LuZening/OPA2000/product1.jpg

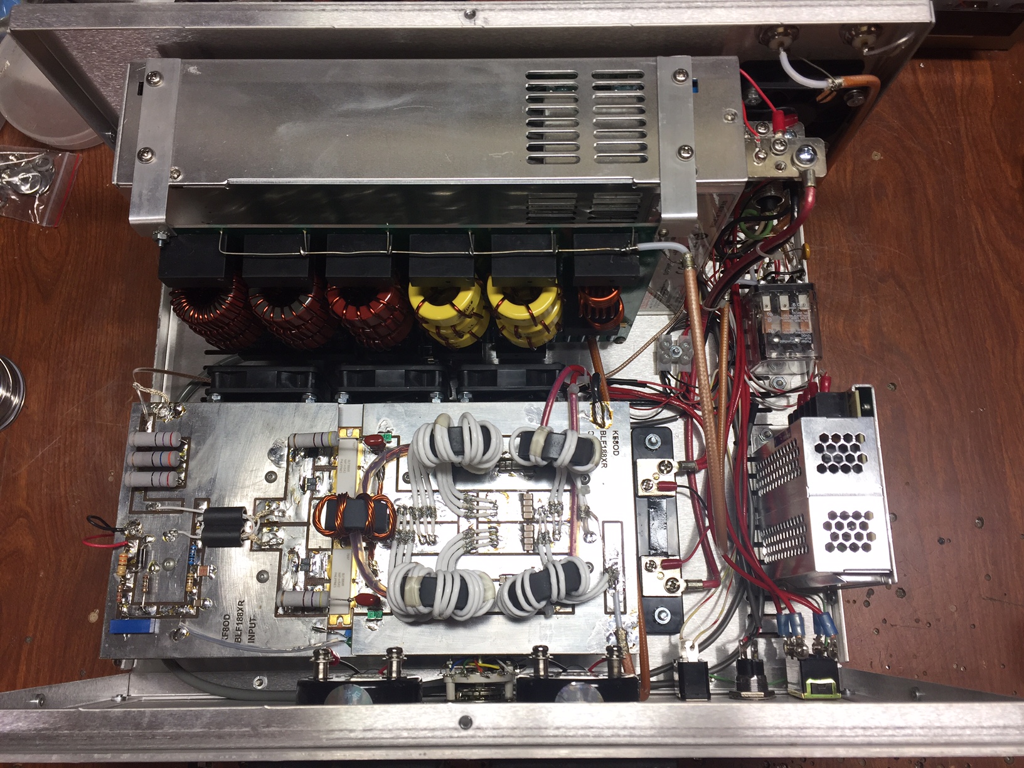
product1.jpg
