LuZening/OPA2000/BOM_HighSidePower_PCB1_2026-02-28.xlsx

No. | Quantity | Comment | Designator | Footprint | Value | Manufacturer Part | Manufacturer | Supplier Part | Supplier
1 | 1 | 3V3 | 3V3 | Test-Point-0.5mm
2 | 1 | 12V | 12V | Test-Point-0.5mm
3 | 8 | 100nF | C1,C4,C8,C18,C19,C21,C22,C25 | C0805 | 100nF | CC0805KRX7R9BB104 | YAGEO(国巨) | C49678 | LCSC
4 | 3 | 1nF | C2,C3,C5 | C0805 | 1nF | CC0805KRX7R9BB102 | YAGEO(国巨) | C94121 | LCSC
5 | 4 | 1uF | C6,C7,C15,C20 | C0805 | 1uF | CC0805KKX7R9BB105 | YAGEO(国巨) | C91185 | LCSC
6 | 1 | 2.2nF | C9 | C0805 | 2.2nF | CC0805KRX7R9BB222 | YAGEO(国巨) | C107146 | LCSC
7 | 2 | 22uF | C10,C12 | CAP-SMD_BD6.3-L6.6-W6.6-FD-A | 22uF | 2201010609TR | NJCON(永立) | C19270543 | LCSC
8 | 1 | 10nF | C11 | C1206 | 10nF | 1206B103K251NT | FH(风华) | C913956 | LCSC
9 | 2 | 100nF 100V | C13,C17 | C0805 | 100nF 100V | CL21B104KCFNNNE | SAMSUNG(三星) |  | LCSC
10 | 2 | 4.7uF | C14,C16 | C1210 | 4.7uF | FS32X475K101EGG | PSA(信昌电陶) | C381466 | LCSC
11 | 2 | 22uF | C23,C24 | C1206 | 22uF | CL31A226KAHNNNE | SAMSUNG(三星) | C12891 | LCSC
12 | 6 | M2螺丝 | CONN1,CONN2,CONN3,CONN4,CONN5,CONN6 | PCB-10B-M4
13 | 1 | 5.0SMDJ60CA | D1 | SMC_L6.9-W5.9-LS7.9-BI |  | 5.0SMDJ60CA | R+O(宏嘉诚) | C42371726 | LCSC
14 | 2 | B5819W SL | D2,D3 | SOD-123_L2.7-W1.6-LS3.7-RD-1 |  | B5819W SL | CJ(江苏长电/长晶) | C8598 | LCSC
15 | 2 | FR107 | D5,D6 | SOD-123_L2.8-W1.8-LS3.7-RD |  | FR107 | JSMSEMI(杰盛微) | C963379 | LCSC
16 | 1 | SS310 | D7 | SMA_L4.3-W2.6-LS5.0-FD |  | SS310 | R+O(宏嘉诚) | C7420364 | LCSC
17 | 1 | ZMM5V1 | D8 | LL-34_L3.5-W1.5-RD |  | ZMM5V1 | HXY MOSFET(华轩阳电子) | C5345992 | LCSC
18 | 1 | SMD4532-075NF | GDT1 | DIO-DT-SMD_L4.5-W3.2 |  | SMD4532-075NF | RUILON(瑞隆源) | C9234 | LCSC
19 | 1 | 0 | GNDSPLIT1 | GNDSPLIT0603 | 0
20 | 1 | GOSC | GOSC | Test-Point-0.5mm
21 | 2 | ZX-XH2.54-4PWT | J1,J2 | CONN-SMD_4P-P2.50-WAFER-254W-4P |  | ZX-XH2.54-4PWT | Megastar(兆星) | C7429673 | LCSC
22 | 4 | ZX-XH2.54-2PWT | J3,J4,J5,J6 | CONN-SMD_2P-P2.54_MEGASTAR_ZX-XH2.54-2PWT |  | ZX-XH2.54-2PWT | Megastar(兆星) | C7429671 | LCSC
23 | 1 | 33uH | L1 | IND-SMD_L13.45-W12.6 | 33uH | MWSA1206S-330MT | Sunlord(顺络) | C408530 | LCSC
24 | 1 | LED_0805-G | LED1 | LED_0805
25 | 1 | OSCH | OSCH | Test-Point-0.5mm
26 | 1 | OSCL | OSCL | Test-Point-0.5mm
27 | 1 | SP010N01BGHTO | Q1 | TOLL-8_L10.4-W9.9-P1.20-LS11.7-BL_2 |  | SP010N01BGHTO | Siliup(矽普) | C22385350 | LCSC
28 | 1 | 2N7002 | Q2 | SOT-23-3_L2.9-W1.3-P1.90-LS2.4-BR |  | 2N7002 | R+O(宏嘉诚) | C7420321 | LCSC
29 | 1 | 2N5401 | Q3 | SOT-23-3_L2.9-W1.3-P0.95-LS2.4-BR |  | 2N5401 | LJ(朗捷) | C18195370 | LCSC
30 | 1 | CMD25P15 | Q4 | TO-252-2_L6.5-W6.1-P4.56-LS9.9-BR-CW-1 |  | CMD25P15 | Cmos(广东场效应半导体) | C18198747 | LCSC
31 | 8 | 100 | R1,R2,R3,R4,R5,R11,R29,R30 | R0805 | 100
32 | 2 | 10k | R6,R34 | R0805 | 10k
33 | 1 | 300k 1% | R7 | R0805 | 300k 1%
34 | 2 | 10k 1% | R8,R14 | R0805 | 10k 1%
35 | 3 | 100k | R9,R22,R31 | R0805 | 100k
36 | 1 | 39k | R10 | R0805 | 39k
37 | 1 | 51k | R12 | R0805 | 51k
38 | 2 | 1k | R13,R28 | R0805 | 1k
39 | 1 | 3.3k 1% | R15 | R0805 | 3.3k 1%
40 | 1 | 500k | R16 | R1206 | 500k
41 | 1 | 50 | R17 | R0805 | 50
42 | 3 | 5.1k | R18,R25,R26 | R0805 | 5.1k
43 | 1 | 220mΩ | R19 | R1206 | 220mΩ | 1206W4F220LT5E | UNI-ROYAL(厚声) | C25336 | LCSC
44 | 1 | 5.6k 1% | R20 | R0805 | 5.6k 1%
45 | 1 | 4.7k 1% | R21 | R0805 | 4.7k 1%
46 | 1 | 1.8M | R23 | R0805 | 1.8M
47 | 2 | 68k | R24,R27 | R0805 | 68k
48 | 1 | 9.09k | R32 | R0805 | 9.09k
49 | 2 | M3螺丝 | SCREW1,SCREW2 | M3_BD6.2
50 | 1 | ZX-XH2.54-2PLT | SW1 | CONN-SMD_2P-P2.50_HCTL_HC-XH-2ALT |  | ZX-XH2.54-2PLT | Megastar(兆星) | C7429680 | LCSC
51 | 1 | CC6920BSO-50A | U1 | SOP-8_L5.0-W4.0-P1.27-LS6.0-BL |  | CC6920BSO-50A | CrossChip(成都芯进) | C2880436 | LCSC
52 | 2 | ZMM15V | U2,U4 | LL-34_L3.5-W1.5-RD |  | ZMM15V | HXY MOSFET(华轩阳电子) | C5346000 | LCSC
53 | 1 | NSG2000 | U3 | SOIC-8_L4.9-W3.9-P1.27-LS6.1-BL |  | NSG2000 | WXNSIC(国硅集成) | C41414507 | LCSC
54 | 1 | TPSPX3819M5-L-3-3 | U5 | SOT-23-5_L3.0-W1.6-P0.95-LS2.8-BR |  | TPSPX3819M5-L-3-3 | TECH PUBLIC(台舟) | C5370980 | LCSC
55 | 1 | SI5351A-B-GTR | U6 | MSOP-10_L3.0-W3.0-P0.50-LS5.0-BL |  | SI5351A-B-GTR | SKYWORKS/SILICON LABS(芯科) | C504891 | LCSC
56 | 1 | LMR38020FSQDDARQ1 | U7 | ESOP-8_L4.9-W3.9-P1.27-LS6.0-BL-EP |  | LMR38020FSQDDARQ1 | TI(德州仪器) | C20345530 | LCSC
57 | 2 | LMV358Q3MAX/NOPB | U8,U9 | SOIC-8_L5.0-W4.0-P1.27-LS6.1-BL |  | LMV358Q3MAX/NOPB | TI(德州仪器) | C2867121 | LCSC
58 | 1 | ACS758LCB-050B-PFF-T | U10 | SENSOR-TH_ACS758LCB-050B-PFF-T |  | ACS758LCB-050B-PFF-T | ALLEGRO(美国埃戈罗) | C73426 | LCSC
59 | 1 | SN74LVC1G126DBVR | U11 | SOT-23-5_L3.0-W1.7-P0.95-LS2.8-BR |  | SN74LVC1G126DBVR | TI(德州仪器) | C7834 | LCSC
60 | 1 | VG | VG | Test-Point-0.5mm
61 | 1 | VG2 | VG2 | Test-Point-0.5mm
62 | 1 | Vpump | Vpump | Test-Point-0.5mm
63 | 1 | 25MHz | X1 | CRYSTAL-SMD_4P-L3.2-W2.5-BL | 25MHz | X322525MOB4SI | YXC(扬兴晶振) | C9006 | LCSC
