LuZening/OPA2000/MCU_2/BOM_Control_Control_2026-10-15.xlsx

No. | Quantity | Comment | Designator | Footprint | Value | Manufacturer | Supplier
1 | 1 | 4kHz | BZ1 | BUZ-SMD_L5.0-W5.5-P4.60 | 4kHz | 华能 | LCSC
2 | 31 | 100nF | C1,C2,C3,C4,C5,C6,C7,C9,C11,C13,C14,C15,C18,C21,C46,C49,C51,C55,C62,C63,C64,C65,C66,C83,C85,C87,C88,C100,C101,C102,C104 | C0402 | 100nF | SAMSUNG(三星) | LCSC
3 | 2 | 12pF | C8,C12 | C0402 | 12pF | FH(风华) | LCSC
4 | 2 | 2.2uF | C10,C16 | C0603 | 2.2uF
5 | 1 | 2.2uF | C17 | C0603 | 2.2uF | YAGEO(国巨) | LCSC
6 | 2 | 2.2uF | C19,C20 | C0603 | 2.2uF | SAMSUNG(三星) | LCSC
7 | 11 | 10uF | C22,C23,C43,C95,C96,C97,C98,C99,C107,C109,C117 | C0603 | 10uF
8 | 5 | 100nF | C24,C76,C77,C79,C80 | C0402 | 100nF
9 | 18 | 1uF | C25,C26,C27,C28,C29,C34,C39,C40,C47,C52,C56,C57,C58,C59,C89,C90,C91,C92 | C0603 | 1uF
10 | 4 | 22uF | C30,C31,C37,C38 | C1206 | 22uF | Chinocera(华瓷) | LCSC
11 | 3 | 100nF | C32,C33,C36 | C0603 | 100nF
12 | 3 | 18pF | C35,C81,C82 | C0402 | 18pF
13 | 9 | 10nF | C41,C60,C61,C68,C69,C72,C73,C74,C78 | C0402 | 10nF
14 | 12 | 1nF | C42,C44,C53,C54,C108,C110,C111,C112,C113,C114,C115,C116 | C0402 | 1nF | YAGEO(国巨) | LCSC
15 | 5 | 10uF | C45,C48,C50,C93,C94 | CAP-SMD_BD4.0-L4.3-W4.3-LS5.0-FD | 10uF | KNSCHA(科尼盛) | LCSC
16 | 2 | 2.2nF | C67,C70 | C0603 | 2.2nF
17 | 2 | 220pF | C71,C75 | C0603 | 220pF
18 | 2 | 33p | C84,C86 | C0603 | 33p
19 | 1 | 1uF | C103 | C0402 | 1uF | SAMSUNG(三星) | LCSC
20 | 2 | 1uF | C105,C106 | C0603 | 1uF | SAMSUNG(三星) | LCSC
21 | 1 | FAN1 | CN1 | CONN-TH_KF2510-4P |  |  | LCSC
22 | 1 | FAN2/PUMP | CN2 | CONN-TH_KF2510-4P |  |  | LCSC
23 | 1 | PJ-320D | CN3 | AUDIO-SMD_PJ-320D-1 |  | SHOU HAN(首韩) | LCSC
24 | 1 | REAR | CN4 | FPC-SMD_KH-FG0.5-H2.0-20PIN |  | kinghelm(金航标) | LCSC
25 | 1 | SMAJ15CA | D1 | SMA_L4.3-W2.6-LS5.0-BI |  | R+O(宏嘉诚) | LCSC
26 | 16 | BZT52C3V3S | D2,D3,D6,D7,D8,D9,D10,D11,D12,D13,D14,D15,D17,D18,D25,D26 | SOD-323_L1.7-W1.3-LS2.6-RD |  | R+O(宏嘉诚) | LCSC
27 | 7 | 1N5819WS | D4,D16,D19,D20,D21,D22,D23 | SOD-323_L1.8-W1.3-LS2.5-RD |  | Hottech(合科泰) | LCSC
28 | 1 | 1N4148WS | D5 | SOD-323_L1.8-W1.3-LS2.5-RD |  | CJ(江苏长电/长晶) | LCSC
29 | 1 | TPESD0502S6 | D24 | SOT-23-6_L2.9-W1.6-P0.95-LS2.8-BR |  | TECH PUBLIC(台舟) | LCSC
30 | 1 | BSMD1206-200-16V | F1 | F1206 |  | BHFUSE(佰宏) | LCSC
31 | 1 | CTouch | FPC1 | FPC-SMD_6P-P0.50_HC-FPC-05-09-6RLTAG |  | HCTL(华灿天禄) | LCSC
32 | 1 | FPC-05FB-40PH20 | FPC2 | FPC-SMD_40P-P0.50_XUNPU_FPC-05FB-40PH20 |  | XUNPU(讯普) | LCSC
33 | 1 | EXT_DISP | FPC3 | FPC-SMD_8P-P0.50_HC-FPC-05-09-8RLTAG |  | HCTL(华灿天禄) | LCSC
34 | 1 | PROG | H1 | HDR-SMD_8P-P2.54-V-M-R2-C4-LS7.4 |  | LAILAN(莱联) | LCSC
35 | 1 | CAN | H2 | CONN-SMD_B2B-PH-SM4-TB-LF-SN |  | JST | LCSC
36 | 1 | PSU ON | H3 | CONN-SMD_B2B-PH-SM4-TB-LF-SN |  | JST | LCSC
37 | 1 | PTT IN | H4 | CONN-SMD_B2B-PH-SM4-TB-LF-SN |  | JST | LCSC
38 | 1 | RELAY1 | H5 | CONN-SMD_B2B-PH-SM4-TB-LF-SN |  | JST | LCSC
39 | 1 | RELAY2 | H6 | CONN-SMD_B2B-PH-SM4-TB-LF-SN |  | JST | LCSC
40 | 1 | RF_IN | H7 | CONN-SMD_6P-P2.00_XUNPU_WAFER-PH2.0-6PWB |  | XUNPU(讯普) | LCSC
41 | 1 | NTC | H8 | CONN-SMD_B2B-PH-SM4-TB-LF-SN |  | JST | LCSC
42 | 1 | LIGHT | H9 | CONN-SMD_4P-P2.00_WAFER-200L-4A |  | XUNPU(讯普) | LCSC
43 | 1 | POWER | H10 | CONN-SMD_4P-P2.00_XUNPU_WAFER-PH2.0-4PWB |  | XUNPU(讯普) | LCSC
44 | 1 | POWER EXT | H11 | CONN-SMD_4P-P2.00_MEGASTAR_ZX-PH2.0-LT4P |  | Megastar(兆星) | LCSC
45 | 1 | LPF_SW | H12 | CONN-SMD_8P-P2.00_XUNPU_WAFER-PH2.0-8PWB |  | XUNPU(讯普) | LCSC
46 | 1 | COUPLER1 | H13 | CONN-SMD_6P-P2.00_XUNPU_WAFER-PH2.0-6PWB |  | XUNPU(讯普) | LCSC
47 | 1 | COUPLER2 | H14 | CONN-SMD_6P-P2.00_XUNPU_WAFER-PH2.0-6PWB |  | XUNPU(讯普) | LCSC
48 | 1 | 3.3uH | L1 | IND-SMD_L4.0-W4.0 | 3.3uH | cjiang(长江微电) | LCSC
49 | 2 | BLM18PG121SN1D | L2,L3 | L0603 |  | muRata(村田) | LCSC
50 | 1 | 22uH | L4 | IND-SMD_L4.0-W4.0_FNR40XXS | 22uH | cjiang(长江微电) | LCSC
51 | 1 | KT-0805G | LED1 | LED0805-R-RD |  | KENTO | LCSC
52 | 1 | KT-0805R | LED2 | LED0805-R-RD |  | KENTO | LCSC
53 | 3 | S8050 | Q1,Q8,Q9 | SOT-23-3_L2.9-W1.3-P1.90-LS2.4-BR |  | JSMSEMI(杰盛微) | LCSC
54 | 1 | AO3402 | Q2 | SOT-23_L2.9-W1.3-P1.90-LS2.4-BR |  | AOS | LCSC
55 | 3 | SS8050 | Q3,Q4,Q5 | SOT-23-3_L2.9-W1.3-P1.90-LS2.4-BR |  | R+O(宏嘉诚) | LCSC
56 | 2 | S9018 | Q6,Q7 | SOT-23-3_L2.9-W1.3-P1.90-LS2.4-BR |  | R+O(宏嘉诚) | LCSC
57 | 1 | SS8550 | Q10 | SOT-23-3_L2.9-W1.3-P1.90-LS2.4-BR |  | R+O(宏嘉诚) | LCSC
58 | 4 | 22k | R1,R5,R6,R11 | R0402 | 22k | UNI-ROYAL(厚声) | LCSC
59 | 9 | 2.2k | R2,R4,R7,R8,R23,R28,R37,R84,R94 | R0402 | 2.2k
60 | 21 | 22k | R3,R13,R15,R24,R25,R40,R41,R59,R60,R64,R65,R69,R71,R72,R73,R88,R109,R110,R111,R112,R113 | R0402 | 22k
61 | 3 | 2.2k | R9,R10,R75 | R0402 | 2.2k | UNI-ROYAL(厚声) | LCSC
62 | 1 | 22 | R12 | R0603 | 22 | UNI-ROYAL(厚声) | LCSC
63 | 2 | 100k | R14,R18 | R0603 | 100k
64 | 2 | 60 | R16,R17 | R0603 | 60
65 | 3 | 56k | R19,R21,R22 | R0402 | 56k
66 | 1 | 10K | R20 | R0603 | 10K
67 | 5 | 220k | R26,R27,R38,R70,R74 | R0402 | 220k
68 | 14 | 22 | R29,R30,R78,R79,R80,R81,R82,R83,R85,R86,R87,R98,R117,R118 | R0402 | 22
69 | 7 | 22 | R36,R43,R45,R47,R49,R76,R77 | R0603 | 22
70 | 1 | 22k | R39 | R0603 | 22k
71 | 9 | 12k | R42,R50,R51,R56,R57,R63,R66,R67,R68 | R0603 | 12k
72 | 4 | 8.2k | R44,R46,R48,R52 | R0603 | 8.2k
73 | 6 | 220 | R53,R54,R55,R58,R61,R62 | R0603 | 220
74 | 1 | 1M | R114 | R0603 | 1M
75 | 2 | 5.1k | R115,R116 | R0402 | 5.1k
76 | 2 | 6GHz | RF1,RF2 | IPEX-SMD_3P-L2.6-W2.6-LS3.0_RF1200001R | 6GHz | HanElectricity(瀚源) | LCSC
77 | 14 | 22Ω | RN1,RN2,RN3,RN4,RN5,RN6,RN7,RN8,RN9,RN10,RN11,RN12,RN13,RN14 | RES-ARRAY-SMD_0603-8P-L3.2-W1.6-BL | 22Ω | UNI-ROYAL(厚声) | LCSC
78 | 1 | HDR-M_2.54_1x1P | S1 | 屏蔽罩26x26夹6.5x1.28
79 | 3 | M2螺丝 | SCREW1,SCREW2,SCREW3 | M2螺丝
80 | 1 | M2螺丝 | SCREW4 | M2-D2.8-BD4.4
81 | 1 | TF-01A | SD1 | TF-SMD_TF-01A |  | 韩国韩荣 | LCSC
82 | 1 | TS1101B16025 | SW1 | KEY-SMD_L6.1-W3.7-LS8.0 |  | HanElectricity(瀚源) | LCSC
83 | 1 | Test-Point | TP2 | Test-Point-0.5mm
84 | 1 | FREQ_DET_A | TP3 | Test-Point-0.5mm
85 | 1 | FREQ_DET_Y | TP4 | Test-Point-0.5mm
86 | 1 | STM32H7B0ZBT | U1 | LQFP-144_L20.0-W20.0-P0.50-LS22.0-TL |  | ST(意法半导体)
87 | 1 | GS8552-SR | U2 | MSOP-8_L3.0-W3.0-P0.65-LS4.9-TL |  | Gainsil(聚洵) | LCSC
88 | 1 | W25Q64JVSSIQ | U3 | SOIC-8_L5.3-W5.3-P1.27-LS8.0-BL |  | Winbond(华邦) | LCSC
89 | 1 | 12V | U4 | CONN-SMD_ZX-XH2.54-2PLT |  | Megastar(兆星) | LCSC
90 | 1 | TJA1042T/1J | U5 | SOIC-8_L5.0-W4.0-P1.27-LS6.0-BL |  | NXP(恩智浦) | LCSC
91 | 1 | ME6211C33M5G-N | U6 | SOT-23-5_L3.0-W1.7-P0.95-LS2.8-BL |  | MICRONE(南京微盟) | LCSC
92 | 2 | 662K | U7,U9 | SOT-23-3_L2.9-W1.3-P1.90-LS2.4-BR |  | HXY MOSFET(华轩阳电子) | LCSC
93 | 1 | TMI3255TF | U8 | SOT-23-6_L2.9-W1.6-P0.95-LS2.9-BL |  | TMI(拓尔微) | LCSC
94 | 1 | TPS2116DRLR | U10 | SOT-583-8_L2.1-W1.6-P0.50-LS1.6-BL |  | TI(德州仪器) | LCSC
95 | 1 | 74LVC1G14GV | U11 | SOT-23-5_L3.0-W1.7-P0.95-LS2.8-BR |  | TECH PUBLIC(台舟) | LCSC
96 | 1 | SI5351A-B-GTR | U12 | MSOP-10_L3.0-W3.0-P0.50-LS5.0-BL |  | SKYWORKS/SILICON LABS(芯科) | LCSC
97 | 2 | TLV9061M5/TR | U13,U14 | SOT-23-5_L3.0-W1.5-P0.95-LS2.8-BL |  | HGSEMI(华冠) | LCSC
98 | 1 | ES8388 | U15 | QFN-28_L4.0-W4.0-P0.45-BL-EP |  | Everest-semi(顺芯) | LCSC
99 | 1 | NS2009 | U16 | MSOP-10_L3.0-W3.0-P0.50-LS5.0-BL |  | Nsiway(纳芯威) | LCSC
100 | 1 | AP3019AKTR-G1 | U19 | SOT-23-6_L2.9-W1.6-P0.95-LS2.8-BR |  | DIODES(美台) | LCSC
101 | 1 | KEYS | U20 | CONN-SMD_4P-P2.00_C2001RS10411M0101RC |  | Megastar(兆星) | LCSC
102 | 1 | TYPE-C 16PIN 2MD(073) | USB1 | USB-C-SMD_TYPE-C-16PIN-2MD-073 |  | SHOU HAN(首韩) | LCSC
103 | 1 | 12.288MHz | X1 | CRYSTAL-SMD_4P-L3.2-W2.5-BL | 12.288MHz | YXC(扬兴晶振) | LCSC
