LuZening/OPA2000/Power_2/HighSideDriving/power_BOM.csv

Comment | Description | Designator | Footprint | LibRef | Pins | Quantity | PartNumber | url
1nF | desc | C1,C20,C24, | 0805_C | libref | 2 | 3
1uF | desc | C2,C12,C25, | 0805_C | libref | 2 | 3
104 63V | desc | C3, | 1206_C | libref | 2 | 1
63V 4.7uF | desc | C4, | 1210_C | libref | 2 | 1
104 | desc | C5, | 0805_C | libref | 2 | 1
104 | desc | C6,C9,C10,C15,C18,C19,C21,C22, | 0805_C | libref | 2 | 8
6.8pF NP0 | desc | C7, | 0805_C | libref | 2 | 1
3.3nF NP0 | desc | C8, | 0805_C | libref | 2 | 1
100uF 16V | desc | C11, | CP_Elec_6.3x5.8 | libref | 2 | 1
103 | desc | C13,C26, | 0805_C | libref | 2 | 2
16V | desc | D1, | LL-34 | libref | 2 | 1
SK310 | desc | D2, | SMC(DO-214AB)_S1 | libref | 2 | 1
D_TVS | desc | D4, | SMC(DO-214AB)_S1 | libref | 2 | 1
IFault | desc | D8, | 0805_LED | libref | 2 | 1
VFault | desc | D9, | 0805_LED | libref | 2 | 1
4148 | desc | D10,D11, | SOD-123 | libref | 2 | 2
Power | desc | D12, | 0805_LED | libref | 2 | 1
Conn_01x02 | desc | J2, | JST_PH_B2B-PH-SM4-TB_02x2.00mm_Straight | libref | 4 | 1
Conn_01x03 | desc | J4, | JST_PH_B3B-PH-SM4-TB_03x2.00mm_Straight | libref | 5 | 1
Conn_01x04 | desc | J5, | JST_PH_B4B-PH-SM4-TB_04x2.00mm_Straight | libref | 6 | 1
120uH 3A | desc | L1, | L_12.6mm_13.5mm | libref | 2 | 1
2N5551 | desc | Q1,Q5, | SOT-23(SOT-23-3) | libref | 3 | 2
SUP90P06 | desc | Q2, | TO-220-External_Thermal_Mount | libref | 3 | 1
8050 | desc | Q6, | SOT-23(SOT-23-3) | libref | 3 | 1
2N5401 | desc | Q7,Q8, | SOT-23(SOT-23-3) | libref | 3 | 2
MJD127 | desc | Q9, | TO-252-2 | libref | 3 | 1
47K 1% | desc | R1,R26, | 0805_R | libref | 2 | 2
2.2K 1% | desc | R2, | 0805_R | libref | 2 | 1
10K | desc | R3,R4,R6,R32,R33,R40,R41,R45, | 0805_R | libref | 2 | 8
100K | desc | R5,R14, | 0805_R | libref | 2 | 2
33K | desc | R7, | 0805_R | libref | 2 | 1
1K | desc | R8,R9,R29,R30,R31, | 0805_R | libref | 2 | 5
2M | desc | R10, | 0805_R | libref | 2 | 1
51K | desc | R11, | 0805_R | libref | 2 | 1
70K 1% | desc | R12, | 0805_R | libref | 2 | 1
47K | desc | R13,R17,R18,R21,R23,R25, | 0805_R | libref | 2 | 6
330K | desc | R15, | 0805_R | libref | 2 | 1
470K | desc | R16, | 0805_R | libref | 2 | 1
68K | desc | R19, | 0805_R | libref | 2 | 1
8.2K | desc | R20, | 0805_R | libref | 2 | 1
2K | desc | R22, | 0805_R | libref | 2 | 1
1R 1/2W | desc | R24, | R_1812_4532Metric | libref | 2 | 1
3.3K | desc | R34,R35, | 0805_R | libref | 2 | 2
10K 1% | desc | R36,R38,R39, | 0805_R | libref | 2 | 3
6.8K 1% | desc | R37, | 0805_R | libref | 2 | 1
680 | desc | R42, | 0805_R | libref | 2 | 1
22K 1% | desc | R43,R44, | 0805_R | libref | 2 | 2
LMV358 | desc | U1,U2, | SOIC-8_150MIL | libref | 8 | 2
TPS54260 | desc | U3, | MSOP-10-1EP_W3mm | libref | 11 | 1
TL431 | desc | U6, | SOT-23(SOT-23-3) | libref | 3 | 1
Zener | desc | TP1, | TestPoint_Pad_1.0x1.0mm | libref | 1 | 1
OVX | desc | TP2, | TestPoint_Pad_1.0x1.0mm | libref | 1 | 1
BuckVin | desc | TP3, | TestPoint_Pad_1.0x1.0mm | libref | 1 | 1
ImSense | desc | TP4, | TestPoint_Pad_1.0x1.0mm | libref | 1 | 1
VmSense | desc | TP5, | TestPoint_Pad_1.0x1.0mm | libref | 1 | 1
12V | desc | TP7, | TestPoint_Pad_1.0x1.0mm | libref | 1 | 1
5V | desc | TP8, | TestPoint_Pad_1.0x1.0mm | libref | 1 | 1
Through Hole Items
1uF 100V | desc | C14, | CP_Radial_D5.0mm_P2.50mm | libref | 2 | 1
GND | desc | J1,J6,J7, | PCB-10B-M4 | libref | 2 | 3
50V in | desc | J3, | PCB-10B-M4 | libref | 2 | 1
Conn_01x04 | desc | J8, | PhoenixContact_MC-G_04x3.81mm_Angled | libref | 4 | 1
ACS758xCB-100U-PFF | desc | U4, | Allegro_CB_PFF | libref | 37 | 1
47K | desc | RV1, | Potentiometer_Bourns_3296W_Vertical | libref | 3 | 1
GND | desc | SC1,SC2, | M3_Screwhole | libref | 7 | 2
