LuZening/OPA2000/RF_2/OPA2000_RF/RF_input/BOM_RF_Input_RF_Input_2026-09-01.xlsx

No. | Quantity | Comment | Designator | Footprint | Value | Manufacturer Part | Manufacturer | Supplier Part | Supplier
1 | 1 | 10uF | C1 | CAP-SMD_BD4.0-L4.3-W4.3-LS5.0-FD | 10uF | RST10UF25V014 | KNSCHA(科尼盛) | C4747969 | LCSC
2 | 5 | 100nF | C2,C5,C16,C20,C24 | C0603 | 100nF
3 | 4 | 100nF | C3,C4,C6,C7 | C0805 | 100nF
4 | 3 | 1uF | C8,C9,C17 | C0603 | 1uF
5 | 2 | 10nF | C10,C11 | C0603 | 10nF
6 | 4 | 1nF | C12,C13,C14,C15 | C0805 | 1nF | CC0805KRX7R9BB104 | YAGEO(国巨) |  | LCSC
7 | 1 | 200pF | C18 | C0603 | 200pF
8 | 1 | 22uF | C19 | C0603 | 22uF
9 | 1 | 1nF | C21 | C0603 | 1nF
10 | 2 | 10uF | C22,C23 | C0603 | 10uF
11 | 1 | BX-PH2.0-6PLT | CONN1 | CONN-SMD_6P-P2.00_BX-PH2.0-6PLT |  | BX-PH2.0-6PLT | Bossie(博锡) | C18077903 | LCSC
12 | 1 | WAFER-PH2.0-2PLB | CONN2 | CONN-TH_2P-P2.00_XUNPU_WAFER-PH2.0-2PLB |  | WAFER-PH2.0-2PLB | XUNPU(讯普) | C3029431 | LCSC
13 | 1 | D_PIN | D1 | DIO-SMD_L3.0-W2.2_MA4P1250-1072T-A1K2 | D_PIN
14 | 5 | 1N5819WS | D2,D3,D28,D29,D30 | SOD-323_L1.8-W1.3-LS2.5-RD |  | 1N5819WS | Hottech(合科泰) | C191023 | LCSC
15 | 1 | ZMM3V3 | D4 | LL-34_L3.5-W1.5-RD |  | ZMM3V3 | Slkor(萨科微) | C707189 | LCSC
16 | 20 | DSS34 | D5,D6,D7,D8,D9,D10,D11,D12,D13,D14,D17,D18,D19,D20,D21,D22,D23,D24,D25,D26 | SOD-123_L2.8-W1.8-LS3.7-RD-2 |  | DSS34 | CJ(江苏长电/长晶) | C2923958 | LCSC
17 | 2 | BAT54S | D15,D16 | SOT-23-3_L2.9-W1.3-P1.90-LS2.4-BR |  | BAT54S | R+O(宏嘉诚) | C7420333 | LCSC
18 | 7 | Test-Point | IM,IMREF,OPATT,OPREF,OVERP,VBIAS,VPIN | Test-Point-0.5mm
19 | 1 | RFin | J1 | RF_conn_pad_2 | SMA
20 | 1 | 10T | L1 | 28B0562-100-RFC | 10T
21 | 2 | KT-0805R | LED1,LED2 | LED0805-R-RD |  | KT-0805R | KENTO | C2295 | LCSC
22 | 1 | 2N5551 | Q1 | SOT-23-3_L2.9-W1.3-P1.90-LS2.4-BL-1 |  | 2N5551 | GOODWORK(固得沃克) | C51912414 | LCSC
23 | 1 | BCP56(RANGE:100-250) | Q2 | SOT-223-3_L6.5-W3.4-P2.30-LS7.0-BR |  | BCP56(RANGE:100-250) | CJ(江苏长电/长晶) | C95810 | LCSC
24 | 1 | BLF188XR | Q3 | BLF188XR-Gate | BLF188XR
25 | 1 | NPN_BIAS_TEMPSENSE | Q4 | TO-92-SMD
26 | 1 | SS8550 Y2(RANGE:200-350) | Q5 | SOT-23-3_L2.9-W1.3-P1.90-LS2.4-BR |  | SS8550 Y2(RANGE:200-350) | CJ(江苏长电/长晶) | C8542 | LCSC
27 | 1 | SS8550 | Q6 | SOT-23-3_L2.9-W1.3-P1.90-LS2.4-BR |  | SS8550 | R+O(宏嘉诚) | C7420371 | LCSC
28 | 1 | SS8050 | Q7 | SOT-23-3_L2.9-W1.3-P1.90-LS2.4-BR |  | SS8050 | R+O(宏嘉诚) | C7420370 | LCSC
29 | 2 | 10 | R1,R7 | R2512 | 10 | CR1812J240RE04Z | EVER OHMS(天二科技) |  | LCSC
30 | 2 | 240Ω | R2,R2* | R2512 | 240Ω | CR1812J240RE04Z | EVER OHMS(天二科技) | C149837 | LCSC
31 | 9 | 22k | R3,R6,R10,R11,R33,R37,R38,R40,R41 | R0603 | 22k
32 | 2 | 220k | R4,R27 | R0603 | 220k
33 | 2 | 10k | R5,R13 | R0603 | 10k
34 | 2 | 1k | R8,R39 | R0603 | 1k
35 | 2 | 220 | R9,R25 | R0603 | 220
36 | 9 | 2.2k | R12,R28,R29,R30,R31,R32,R34,R42,R43 | R0603 | 2.2k
37 | 4 | 22 | R14,R15,R35,R46 | R0603 | 22
38 | 1 | 33 | R16 | R2512 | 33 | CR1812J240RE04Z | EVER OHMS(天二科技) |  | LCSC
39 | 8 | 47 | R17,R18,R19,R20,R21,R22,R23,R24 | R0805 | 47
40 | 1 | 2kΩ | R26 | RES-ADJ-SMD_3224W | 2kΩ | 3224W-1-202E | BOURNS | C116322 | LCSC
41 | 3 | 10kΩ | R44,R45,R47 | RES-ADJ-SMD_3314J | 10kΩ | 3314J-1-103E | BOURNS | C36376 | LCSC
42 | 1 | HFD4/5-SR | RELAY1 | RELAY-SMD_HFD4-5-SR |  | HFD4/5-SR | HF(宏发) | C64399 | LCSC
43 | 3 | M3螺丝 | SCREW1,SCREW2,SCREW3 | M3_BD6.2
44 | 1 | Transformer_4_1 | T1 | 28B0562-100-1_4_UNUN | Transformer_4_1
45 | 1 | GS8552-SR | U1 | MSOP-8_L3.0-W3.0-P0.65-LS4.9-TL |  | GS8552-SR | Gainsil(聚洵) | C157716 | LCSC
46 | 1 | LM393 | U2 | MSOP-8_L3.0-W3.0-P0.65-LS4.9-TL |  | LM393 | IDCHIP(英锐芯) | C400839 | LCSC
47 | 2 | GS8721 | U4,U6 | SOT-23-5_L3.0-W1.7-P0.95-LS2.8-BL |  | GS8721 | RUNIC(润石) | C236995 | LCSC
48 | 1 | TL431D | U5 | SOT-23-3_L3.0-W1.7-P0.95-LS2.9-BR |  | TL431D | R+O(宏嘉诚) | C55111440 | LCSC
