LuZening/OPA2000/Interface_2/BOM_Interface_Interface_2026-10-13.xlsx

No. | Quantity | Comment | Designator | Footprint | Value | Manufacturer | Supplier
1 | 13 | 100nF | C1,C2,C3,C4,C6,C12,C13,C18,C24,C25,C28,C30,C31 | C0603 | 100nF
2 | 3 | 1nF | C5,C8,C15 | C0603 | 1nF
3 | 1 | 100pF | C7 | C0603 | 100pF
4 | 3 | 10nF | C9,C22,C26 | C0603 | 10nF
5 | 4 | 1uF | C10,C11,C14,C23 | C0603 | 1uF
6 | 1 | 2.2nF | C16 | C0603 | 2.2nF
7 | 1 | 100uF | C17 | CAP-SMD_BD6.3-L6.6-W6.6-LS7.4-FD | 100uF | ChengTao(诚韬) | LCSC
8 | 4 | 10uF | C19,C20,C21,C29 | C0603 | 10uF
9 | 1 | 270p | C27 | C0603 | 270p
10 | 1 | HYC33-VGA18A-158 | CN1 | DSUB-TH_HYC33-VGA18A-158 |  | HOAUC(华宇创) | LCSC
11 | 5 | PJ-320D | CN2,CN3,CN4,CN5,CN6 | AUDIO-SMD_PJ-320D-1 |  | SHOU HAN(首韩) | LCSC
12 | 1 | REAR | CN7 | FPC-SMD_KH-FG0.5-H2.0-20PIN |  | kinghelm(金航标) | LCSC
13 | 2 | ZX-XH2.54-2PWT | CN8,CN9 | CONN-SMD_2P-P2.54_MEGASTAR_ZX-XH2.54-2PWT |  | Megastar(兆星) | LCSC
14 | 8 | SMF15CA | D1,D2,D3,D4,D5,D6,D9,D12 | SOD-123FL_L2.7-W1.8-LS3.8-BI |  | R+O(宏嘉诚) | LCSC
15 | 4 | SMF5.0CA | D7,D8,D18,D19 | SOD-123FL_L2.7-W1.8-LS3.8-BI |  | R+O(宏嘉诚) | LCSC
16 | 1 | 1N4007W | D10 | SOD-123FL_L2.7-W1.8-LS3.8-RD |  | R+O(宏嘉诚) | LCSC
17 | 7 | 1N5819WS | D11,D15,D17,D20,D21,D22,D23 | SOD-323_L1.8-W1.3-LS2.5-RD |  | Hottech(合科泰) | LCSC
18 | 2 | PESD5V0S1BA,115 | D13,D14 | SOD-323_L1.7-W1.3-LS2.5-BI |  | Nexperia(安世) | LCSC
19 | 1 | PESD1CAN | D16 | SOT-23-3_L2.9-W1.6-P1.90-LS2.8-BR |  | BORN(伯恩半导体) | LCSC
20 | 1 | PROG | H1 | HDR-SMD_8P-P2.54-V-M-R2-C4-LS7.4 |  | LAILAN(莱联) | LCSC
21 | 2 | HX PZ2.54-2x4P ZZ | HEADER1,HEADER2 | HDR-TH_8P-P2.54-V-M-R2-C4-S2.54 |  | hanxia(韩下) | LCSC
22 | 1 | WAFER-MX1.25-4PWB | J1 | CONN-SMD_4P-P1.25_WAFER-MX1.25-4PWB |  | XUNPU(讯普) | LCSC
23 | 1 | 2.2uH | L1 | IND-SMD_L2.5-W2.0_WPN252012H | 2.2uH | Sunlord(顺络) | LCSC
24 | 1 | bead | L2 | L0805 |  | muRata(村田) | LCSC
25 | 1 | KT-0603W | LED1 | LED0603-R-RD_WHITE |  | KENTO | LCSC
26 | 1 | MMBT5551(RANGE:200-300) | Q3 | SOT-23-3_L2.9-W1.3-P1.90-LS2.4-BR |  | CJ(江苏长电/长晶) | LCSC
27 | 1 | MMBT5401(RANGE:200-300) | Q4 | SOT-23-3_L2.9-W1.3-P1.90-LS2.4-BR |  | CJ(江苏长电/长晶) | LCSC
28 | 2 | DTC143ZE | Q5,Q6 | SOT-523-3_L1.6-W0.8-P1.00-LS1.6-BR |  | CJ(江苏长电/长晶) | LCSC
29 | 11 | 22 | R1,R2,R3,R4,R5,R23,R24,R25,R39,R40,R41 | R0603 | 22
30 | 12 | 22k | R6,R9,R10,R14,R16,R30,R37,R38,R42,R43,R45,R46 | R0603 | 22k
31 | 2 | 2.2 | R7,R21 | R0603 | 2.2
32 | 1 | 51k | R8 | R0603 | 51k
33 | 6 | 2.2k | R11,R15,R26,R28,R47,R48 | R0603 | 2.2k
34 | 2 | 220 | R12,R18 | R0603 | 220
35 | 1 | 1k | R13 | R0603 | 1k
36 | 1 | 33k | R17 | R0603 | 33k
37 | 5 | 5.1k | R19,R20,R50,R51,R52 | R0603 | 5.1k
38 | 1 | 100k | R22 | R0603 | 100k
39 | 1 | 100 | R27 | R0603 | 100
40 | 1 | 12k | R29 | R0603 | 12k
41 | 4 | 49.9 | R31,R32,R33,R34 | R0603 | 49.9
42 | 2 | 330 | R35,R36 | R0603 | 330
43 | 1 | 10k | R44 | R0603 | 10k
44 | 1 | HR913550AE | RJ1 | RJ45-TH_HR913550AE |  | HANRUN(汉仁) | LCSC
45 | 1 | M3螺丝 | SCREW1 | M3_Screwhole
46 | 2 | M2螺丝 | SCREW2,SCREW3 | M2-D2.8-BD4.4
47 | 2 | HC-PM254-5.0H-2x4PZ-02A | SOCK1,SOCK2 | CONN-TH_HC-PM254-5.0H-2X4PZ-02A |  | HC(虹成电子) | LCSC
48 | 1 | TK-6580A-1 | SW1 | SW-TH_TK-6580A-1 |  | Yuandi(元迪) | LCSC
49 | 5 | Test-Point | TP1,TP2,TP3,TP4,TP5 | Test-Point-0.5mm
50 | 1 | LM358 | U1 | SOP-8_L4.9-W3.9-P1.27-LS6.0-BL |  | MSKSEMI(美森科) | LCSC
51 | 1 | SP3232EEY-L/TR | U2 | TSSOP-16_L5.0-W4.4-P0.65-LS6.4-BL |  | MaxLinear(迈凌) | LCSC
52 | 1 | PC817C-S | U3 | SOP-4_L6.5-W4.6-P2.54-LS10.3-TL |  | UMW(友台半导体) | LCSC
53 | 1 | TPS60403DBVR | U4 | SOT-23-5_L3.0-W1.7-P0.95-LS2.8-BR |  | TI(德州仪器) | LCSC
54 | 1 | SY8088A | U5 | SOT-23-5_L2.9-W1.6-P0.95-LS2.8-BL |  | TECH PUBLIC(台舟) | LCSC
55 | 1 | LAN8720 | U6 | QFN24
56 | 1 | 2.4GHz | U7 | WIFI-SMD_ESP32-WROVER-E | 2.4GHz | ESPRESSIF(乐鑫) | LCSC
57 | 1 | LM393 | U8 | SOP-8_L4.9-W3.9-P1.27-LS6.0-BL |  | IDCHIP(英锐芯) | LCSC
58 | 1 | TYPE-C 16PIN 2MD(073) | USB1 | USB-C-SMD_TYPE-C-16PIN-2MD-073 |  | SHOU HAN(首韩) | LCSC
