LuZening/OPA2000/LPF_2/LPF_BOM.csv

Comment | Description | Designator | Footprint | LibRef | Pins | Quantity | PartNumber | url
104 | desc | C2, | 0805_C | libref | 2 | 1
SD103 | desc | D1,D2,D3,D4,D5,D6,D7,D8, | SOD-123 | libref | 2 | 8
ULN2003A | desc | U1, | SOIC-16_150MIL | libref | 16 | 1
JST_PH_B8B-PH-SM4-TB_1x08-1MP_P2.00mm_Vertical | desc | REF**, | JST_PH_B8B-PH-SM4-TB_1x08-1MP_P2.00mm_Vertical | libref | 10 | 1
10pF 3KV | desc | C3,C3,C3,C3,C3,C3,C3,C3,C3,C3,C3,C3,C4,C4,C4,C4,C4,C4,C4,C4,C4,C4,C4,C4,C5,C5,C5,C5,C5,C5,C5,C5,C5,C5,C5,C5,C6,C6,C6,C6,C6,C6,C6,C6,C6,C6,C6,C6,C7,C7,C7,C7,C7,C7,C7,C7,C7,C7,C7,C7,C7,C7,C7,C7,C7,C7,C7,C7,C7,C7,C7,C7,C7,C7,C7,C7,C7,C7,C7,C7,C7,C7,C7,C7,C7,C7,C7,C7,C7,C7,C7,C7,C7,C7,C7,C7,C7,C7,C7,C7,C7,C7,C7,C7,C7,C7,C7,C7,C7,C7,C7,C7,C7,C7,C7,C7,C7,C7,C7,C7,C7,C7,C7,C7,C7,C7,C7,C7,C7,C7,C7,C7,C7,C7,C7,C7,C7,C7,C18,C18,C18,C18,C18,C18,C18,C18,C18,C18,C18,C18,C19,C19,C19,C19,C19,C20,C20,C20,C20,C21,C21,C21,C21,C21,C21,C22, | C_1812_4532Metric_Pad1.57x3.40mm_HandSolder | libref | 2 | 166
Through Hole Items
10uF | desc | C1, | CP_Radial_D5.0mm_P2.50mm | libref | 2 | 1
RF out | desc | J1, | RF_conn_pad_short | libref | 33 | 1
RF in | desc | J2, | RF_conn_pad_short | libref | 33 | 1
Conn_01x08 | desc | J3, | JST_XH_B08B-XH-A_08x2.50mm_Straight | libref | 8 | 1
G2RL-1-E | desc | K1,K2,K3,K4,K5,K6,K7,K8, | G2RL-1-E | libref | 8 | 8
420nH 6T@T106-6 | desc | L1,L3, | Core_T106 | libref | 2 | 2
570nH 7T@T106-6 | desc | L2,L4,L6, | Core_T106 | libref | 2 | 3
740nH 8T@T106-6 | desc | L5, | Core_T106 | libref | 2 | 1
940nH 9T@T106-6 | desc | L7,L9, | Core_T106 | libref | 2 | 2
1.16uH 10T@T106-6 | desc | L8, | Core_T106 | libref | 2 | 1
2.48uH 15T@T106-2 | desc | L10,L11,L12, | Core_T106 | libref | 2 | 3
4.4uH 20T@T130-2 | desc | L13,L15, | Core_T130 | libref | 2 | 2
5.32uH 22T@T130-2 | desc | L14, | Core_T130 | libref | 2 | 1
Bridge | desc | JP1,JP2,JP3,JP4, | Core_T106 | libref | 2 | 4
Bridge | desc | JP5, | Core_T130 | libref | 2 | 1
GND | desc | SC1,SC2,SC3,SC4, | M3_Screwhole | libref | 7 | 4
