LuZening/OPA2000/RF_2/Directional_Coupler_Linear/Directional_coupler_BOM.csv

Comment | Description | Designator | Footprint | LibRef | Pins | Quantity | PartNumber | url
10p 1KV | desc | C1, | 1206_C | libref | 2 | 1
104 | desc | C2,C4,C8,C14,C16, | 0805_C | libref | 2 | 5
1uF | desc | C3,C9,C10,C15, | 0805_C | libref | 2 | 4
1n | desc | C5, | 0805_C | libref | 2 | 1
10n | desc | C6,JP1,JP2, | 0805_C | libref | 2 | 3
10nF | desc | C12, | 0805_C | libref | 2 | 1
1nF | desc | C13, | 0805_C | libref | 2 | 1
1N5819 | desc | D1,D2,D3,D5,D7,D8,D9, | SOD-123 | libref | 2 | 7
BAT54S | desc | D4,D6, | SOT-23(SOT-23-3) | libref | 3 | 2
Singal | desc | J4, | JST_PH_S6B-PH-SM4-TB_1x06-1MP_P2.00mm_Horizontal | libref | 8 | 1
10uH | desc | L1,L2, | 0805_L | libref | 2 | 2
100 | desc | R1,R2,R3,R16,R17,R18, | 0805_R | libref | 2 | 6
1K | desc | R4,R14, | R_0805 | libref | 2 | 2
1M | desc | R5,R15, | R_0805 | libref | 2 | 2
110K | desc | R6,R13, | R_0805 | libref | 2 | 2
330 | desc | R7,R12, | 1206_R | libref | 2 | 2
100 | desc | R8,R11, | 1206_R | libref | 2 | 2
56 2W | desc | R9,R10, | R_2512 | libref | 2 | 2
220K | desc | R19,R20, | 0805_R | libref | 2 | 2
1T | desc | T1,T1, | 5943004901 | libref | 0 | 2
33T | desc | T2,T2, | 5943004901 | libref | 0 | 2
LMV358 | desc | U1,U5, | SOIC-8_150MIL | libref | 8 | 2
LMV358 | desc | U2,U4, | SOT-23-5 | libref | 5 | 2
SPX3819M5-L-3-3 | desc | U3, | SOT-23-5 | libref | 5 | 1
FWD | desc | J5, | JST_PH_S2B-PH-SM4-TB_1x02-1MP_P2.00mm_Horizontal | libref | 4 | 1
REV | desc | J6, | JST_PH_S2B-PH-SM4-TB_1x02-1MP_P2.00mm_Horizontal | libref | 4 | 1
Through Hole Items
RF in | desc | J1, | RF_conn_pad | libref | 39 | 1
Singal | desc | J2, | JST_XH_S06B-XH-A_06x2.50mm_Angled | libref | 6 | 1
RF out | desc | J3, | RF_conn_pad | libref | 39 | 1
GND | desc | SC1,SC2,SC3,SC4, | M3_Screwhole | libref | 7 | 4
