LuZening/OPA2000/structures/screen_frame.SLDPRT

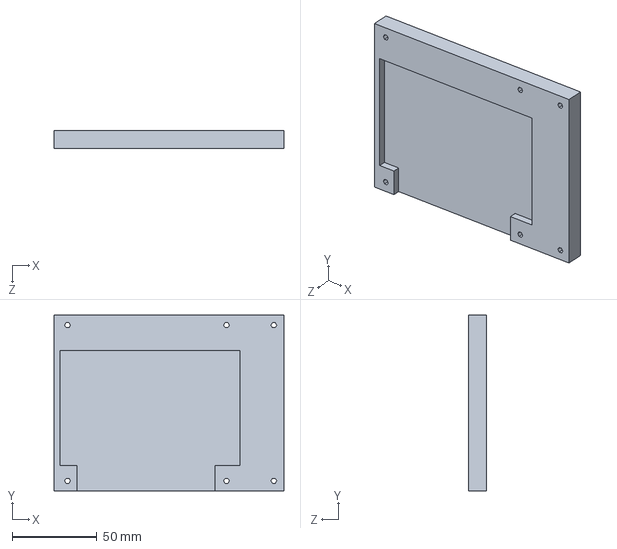
[picture p2: CAD file, 2026-10-26]
structures/screen_frame.SLDPRT
136.0 x 104.0 x 10.5 mm
