LuZening/OPA2000/(list of files, cad)

Other CAD files:
structures/screen_frame_43.SLDPRT
structures/interface_screw.SLDPRT
structures/screen_frame_43.STL
