LuZening/OPA2000/Code_2/OPA2000_h7/User/TODO-PSU远程控制.txt

================================================================================
【待办】PSU（外部电源）远程控制 —— CAT 命令协议未定
创建日期：2026-10-15
状态：骨架已就位，功能未启用（等协议）
================================================================================

一、现状：骨架已建好，但没有任何代码路径能真正操作 PSU
--------------------------------------------------------------------------------
已实现的部分：

  power_psu_on()  / power_psu_off()      power_control.c，两个函数都幂等
  CMD_PSU_ON     / CMD_PSU_OFF           comm.h 枚举，已占位
  comm_execute() 里的分支                 comm.c，调用点已写好
  #define COMM_PSU_REMOTE_ENABLED  0      comm.c，功能总开关

未实现的部分：

  comm_parse_command() **不认识任何 PSU 关键字**，所以 CMD_PSU_ON /
  CMD_PSU_OFF 永远不会被解析出来，两个分支不可达。
  这是有意的 —— 协议没定之前不该猜一个语法进去。

二、当前固件里唯一会动 PSU 的地方
--------------------------------------------------------------------------------
  power_soft_off()   关机时把 PG5 拉低，PSU 关机。

除此之外**没有任何地方**会动 PSU：

  power_init()       刻意**不**调 power_psu_on()。PSU 主要由用户自己操作，
                     固件不该擅自开机。上电后 PSU 保持关机，等用户。

二之二、TX 不再要求 PSU / 高压已开
--------------------------------------------------------------------------------
  按用户要求：power_tx_enable() 已去掉 g_psu_on 与 g_hv_on 两项检查。
  PA 有没有电不归固件在"请求发射"这一刻裁决 —— 操作员或 PSU 随时可能上电，
  拒绝只是徒增困扰。

  保留的两条与电源相关的联锁，都是硬件性质而非策略判断：
    power_rail_busy()   偏置正在稳定的 10 ms 内不许发射（真实硬件瞬态）
    g_allow_rf / g_alert_flag   安全原因

三、硬件事实（已核实，不要凭直觉写反极性）
--------------------------------------------------------------------------------
  PSU = Power Supply Unit，是**外部设备**，PG5 只是 MCU 进去的控制线。

      PG5 ──> NPN Q9（反相）──> PC13 = PWR_WKUP4

  Q9 反相，所以**从 MCU 的 GPIO 视角**看极性是「高电平开机」：

      PG5 高 → Q9 导通 → PC13 拉到 GND   → PSU 开机
      PG5 低 → Q9 截止 → PC13 回到上拉   → PSU 关机

  这与设计要求 6 节和 hw_pinmap.h 的 PSU_ON_PWR_ON/PSU_ON_PWR_OFF 一致。
  ⚠ 别按"低有效"的直觉写反 —— 板上是反相的，MCU 侧看是高有效。

四、协议待定项（需要你确定后我才好把开关打开）
--------------------------------------------------------------------------------
  □ 走 ASCII 行协议（跟现有的 STATUS / SET FREQ 同一套）还是二进制包？
  □ 关键字怎么写？候选：
        "PSU ON" / "PSU OFF"        与现有 SET FREQ 风格一致
        "PSU 1" / "PSU 0"            更短
        "POWER ON" / "POWER OFF"     但 POWER 可能与高压按钮混淆，不建议
  □ 要不要回读查询命令（"PSU?"），以便确认当前状态？
  □ 返回什么字符串？现在骨架里写的是 "PSU ON" / "PSU OFF"，
    出错是 "ERROR: PSU control not implemented"，要不要统一格式？
  □ 远控开机是否需要与本地联锁（g_allow_rf / g_alert_flag）一致？
    即：保护告警锁存中收到 "PSU ON" 要不要拒绝？
    现在的骨架是**不拒绝**的（power_psu_on() 本身不带联锁）。
  □ 是否需要软启动（PSU 上电后等电压稳定再允许上高压）？
    如果需要，要加一个 g_psu_settled 之类的标志 + 延时状态机，
    这会影响 power_hv_enable() 该不该检查它。

五、协议定下来之后的改动点（届时执行，现在不做）
--------------------------------------------------------------------------------
  1. comm.c：comm_parse_command() 里加关键字识别，
     例如 if (strcasecmp(cmd, "PSU ON") == 0) return CMD_PSU_ON;
  2. comm.c：把 COMM_PSU_REMOTE_ENABLED 改成 1
  3. 如果要回读，加 CMD_GET_PSU 与对应回复（输出 g_psu_on）
  4. 如果需要联锁或软启动，加上面第 4 条勾选项对应的逻辑
  5. 在 User/Tests/ 加 comm 命令解析的用例

================================================================================
六、相关文件速查
================================================================================
  硬件极性与链路    OPA2000_H7_固件设计要求.txt 第 6 节（287 行）
  GPIO 宏           User/Inc/hw_pinmap.h    MAIN_PSU_ON_SIG (PG5)
  电源函数          User/Src/power_control.c   power_psu_on / power_psu_off
  命令骨架          User/Src/comm.c        CMD_PSU_ON / CMD_PSU_OFF 分支
  协议总开关        User/Src/comm.c        COMM_PSU_REMOTE_ENABLED
  三条轨的关系      User/Inc/power_control.h  文件头的对照表
