LuZening/OPA2000/MCU_2/RFsample.asc

C1: cap; 10n
C2: cap; 1p
C3: cap; 10n
C4: cap; 33p
C5: cap; 18p
Q1: npn; 2N3904
R1: res; 1k
R2: res; 12k
R3: res; 12k
R4: res; 220
R5: res; 150
R6: res; 50
R7: res; 12k
R8: res; 12k
U1: opamp
V1: signal; SINE(0 0.5 10455k)
V2: voltage; 3.3
V3: signal; PULSE(0 3 0 0 0 0.05u 0.1u)
Named nets: 0, VCC
.tran 100u
.lib opamp.sub
