LuZening/OPA2000/Power_2/HighSideDriving/power.kicad_pcb

## KiCad design Power_2/HighSideDriving/power.kicad_pcb (2026-10-17)

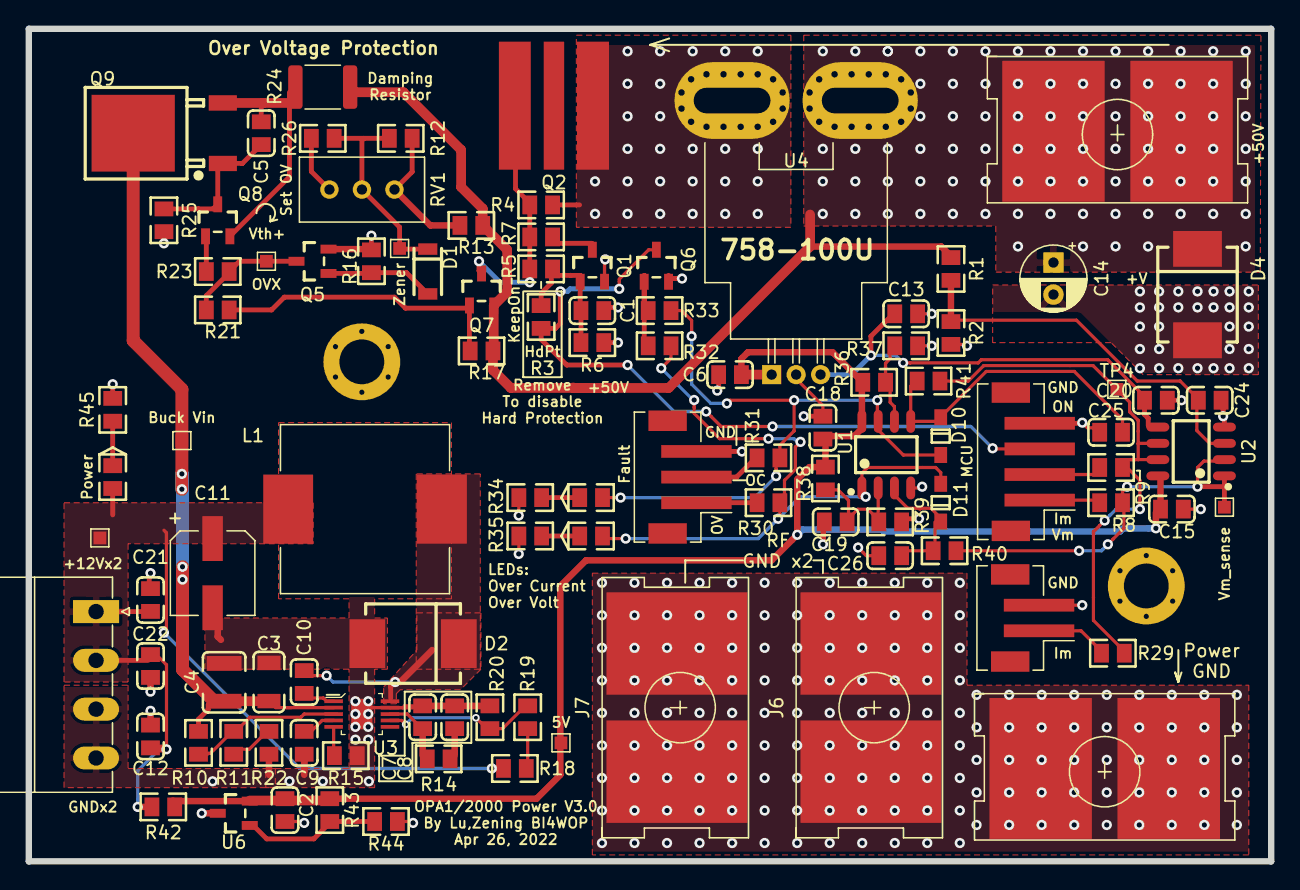
[picture p3: board power.kicad_pcb from above]

Board: 2 copper layers, 97.0 x 65.0 mm, 105 parts (0 on the bottom side), 48 nets.

Parts:
C1, C20, C24: 1nF; 0805_C
C2, C12, C25: 1uF; 0805_C
C3: 104 63V; 1206_C
C4: 63V 4.7uF; 1210_C
C5, C6, C9, C10, C15, C18, C19, C21, C22: 104; 0805_C
C7: 6.8pF NP0; 0805_C
C8: 3.3nF NP0; 0805_C
C11: 100uF 16V; CP_Elec_6.3x5.8
C13, C26: 103; 0805_C
C14: 1uF 100V; CP_Radial_D5.0mm_P2.50mm
D1: 16V; LL-34
D2: SK310; SMC(DO-214AB)_S1
D4: D_TVS; SMC(DO-214AB)_S1
D8: IFault; 0805_LED
D9: VFault; 0805_LED
D10, D11: 4148; SOD-123
D12: Power; 0805_LED
J1, J6, J7: GND; PCB-10B-M4
J2: Conn_01x02; JST_PH_B2B-PH-SM4-TB_02x2.00mm_Straight
J3: 50V in; PCB-10B-M4
J4: Conn_01x03; JST_PH_B3B-PH-SM4-TB_03x2.00mm_Straight
J5: Conn_01x04; JST_PH_B4B-PH-SM4-TB_04x2.00mm_Straight
J8: Conn_01x04; PhoenixContact_MC-G_04x3.81mm_Angled
L1: 120uH 3A; L_12.6mm_13.5mm
Q1, Q5: 2N5551; SOT-23(SOT-23-3)
Q2: SUP90P06; TO-220-External_Thermal_Mount
Q6: 8050; SOT-23(SOT-23-3)
Q7, Q8: 2N5401; SOT-23(SOT-23-3)
Q9: MJD127; TO-252-2
R1, R26: 47K 1%; 0805_R
R2: 2.2K 1%; 0805_R
R3, R4, R6, R32, R33, R40, R41, R45: 10K; 0805_R
R5, R14: 100K; 0805_R
R7: 33K; 0805_R
R8, R9, R29, R30, R31: 1K; 0805_R
R10: 2M; 0805_R
R11: 51K; 0805_R
R12: 70K 1%; 0805_R
R13, R17, R18, R21, R23, R25: 47K; 0805_R
R15: 330K; 0805_R
R16: 470K; 0805_R
R19: 68K; 0805_R
R20: 8.2K; 0805_R
R22: 2K; 0805_R
R24: 1R 1/2W; R_1812_4532Metric
R34, R35: 3.3K; 0805_R
R36, R38, R39: 10K 1%; 0805_R
R37: 6.8K 1%; 0805_R
R42: 680; 0805_R
R43, R44: 22K 1%; 0805_R
RV1: 47K; Potentiometer_Bourns_3296W_Vertical
SC1, SC2: GND; M3_Screwhole
TP1: Zener; TestPoint_Pad_1.0x1.0mm
TP2: OVX; TestPoint_Pad_1.0x1.0mm
TP3: BuckVin; TestPoint_Pad_1.0x1.0mm
TP4: ImSense; TestPoint_Pad_1.0x1.0mm
TP5: VmSense; TestPoint_Pad_1.0x1.0mm
TP7: 12V; TestPoint_Pad_1.0x1.0mm
TP8: 5V; TestPoint_Pad_1.0x1.0mm
U1, U2: LMV358; SOIC-8_150MIL
U3: TPS54260; MSOP-10-1EP_W3mm
U4: ACS758xCB-100U-PFF; Allegro_CB_PFF
U6: TL431; SOT-23(SOT-23-3)

Connections:
50Vin: C14.1, D4.2, J3.1, Q7.2, R1.1, R13.1, R17.1, R24.2, U4.4
+5V: C2.1, C6.2, C15.2, C18.2, R36.2, R38.2, R42.2, R43.1, TP8.1, U1.8, U2.8, U4.1, U6.2
+12V: C11.1, C12.1, C21.2, C22.2, D12.1, J8.1, J8.2, L1.2, R18.1, R42.1, TP7.1
/OVX: Q5.3, R21.2, R23.2, TP2.1
Earth: C1.1, C2.2, C3.2, C4.2, C6.1, C7.2, C8.2, C9.2, C11.2, C12.2, C13.1, C14.2, C15.1, C18.1, C19.1, C20.1, C21.1, C22.1, C24.1, C25.1, C26.1, D2.1, D4.1, J1.1, J2.2, J4.3, J5.4, J6.1, J7.1, J8.3, J8.4, Q1.2, Q5.2, Q6.2, R2.2, R6.1, R15.2, R16.2, R20.2, R22.2, R25.2, R26.2, R34.1, R35.1, R37.1, R39.1, R44.2, R45.2, RV1.3, U1.4, U2.4, U3.9, U3.11, U4.2, U6.3
Im_high: D8.1, D10.1, R31.1, R33.1, U1.7
Im_sense: R9.1, R29.1, R41.1, TP4.1, U2.6, U2.7
unnamed: C1.2, Q1.1, R3.2, R5.2, R6.2
unnamed: C3.1, C4.1, Q9.2, R10.1, TP3.1
unnamed: C5.1, Q8.2, Q9.3, R24.1
unnamed: C5.2, Q8.3, Q9.1, R25.1
unnamed: C7.1, R14.1, U3.8
unnamed: C8.1, R14.2
unnamed: C9.1, U3.4
unnamed: C10.1, D2.2, L1.1, U3.10
unnamed: C10.2, U3.1
unnamed: C19.2, R38.1, R39.2, U1.2
unnamed: C25.2, D10.2, R41.2, U1.5
unnamed: C26.2, D11.2, R40.2, U1.3
unnamed: D1.1, Q5.1, R16.1
unnamed: D1.2, R12.2, R26.1, RV1.2, TP1.1
unnamed: D8.2, R34.2
unnamed: D9.2, R35.2
unnamed: D12.2, R45.1
unnamed: J2.1, R29.2
unnamed: J4.1, R30.2
unnamed: J4.2, R31.2
unnamed: J5.1, R8.2
unnamed: J5.2, R9.2
unnamed: Q1.3, R7.2
unnamed: Q2.1, Q7.3, R4.2, R5.1, R7.1
unnamed: Q2.3, R4.1, U4.5
unnamed: Q6.1, R32.2, R33.2
unnamed: Q7.1, R17.2, R21.1
unnamed: Q8.1, R23.1
unnamed: R10.2, R11.1, U3.3
unnamed: R11.2, R22.1
unnamed: R12.1, R13.2, RV1.1
unnamed: R15.1, U3.5
unnamed: R18.2, R19.1
unnamed: R19.2, R20.1, U3.7
unnamed: R36.1, R37.2, U1.6
unnamed: R43.2, R44.1, U6.1
PWR_on: J5.3, Q6.3, R3.1
VImain: C13.2, C20.2, U2.5, U4.3
VVm_sense: C24.2, R1.2, R2.1, U2.3
Vm_high: D9.1, D11.1, R30.1, R32.1, U1.1
Vm_sense: R8.1, R40.1, TP5.1, U2.1, U2.2
