LuZening/OPA2000/RF_2/Directional_Coupler_Linear/Directional_coupler.kicad_pcb

## KiCad design RF_2/Directional_Coupler_Linear/Directional_coupler.kicad_pcb (2026-10-17)

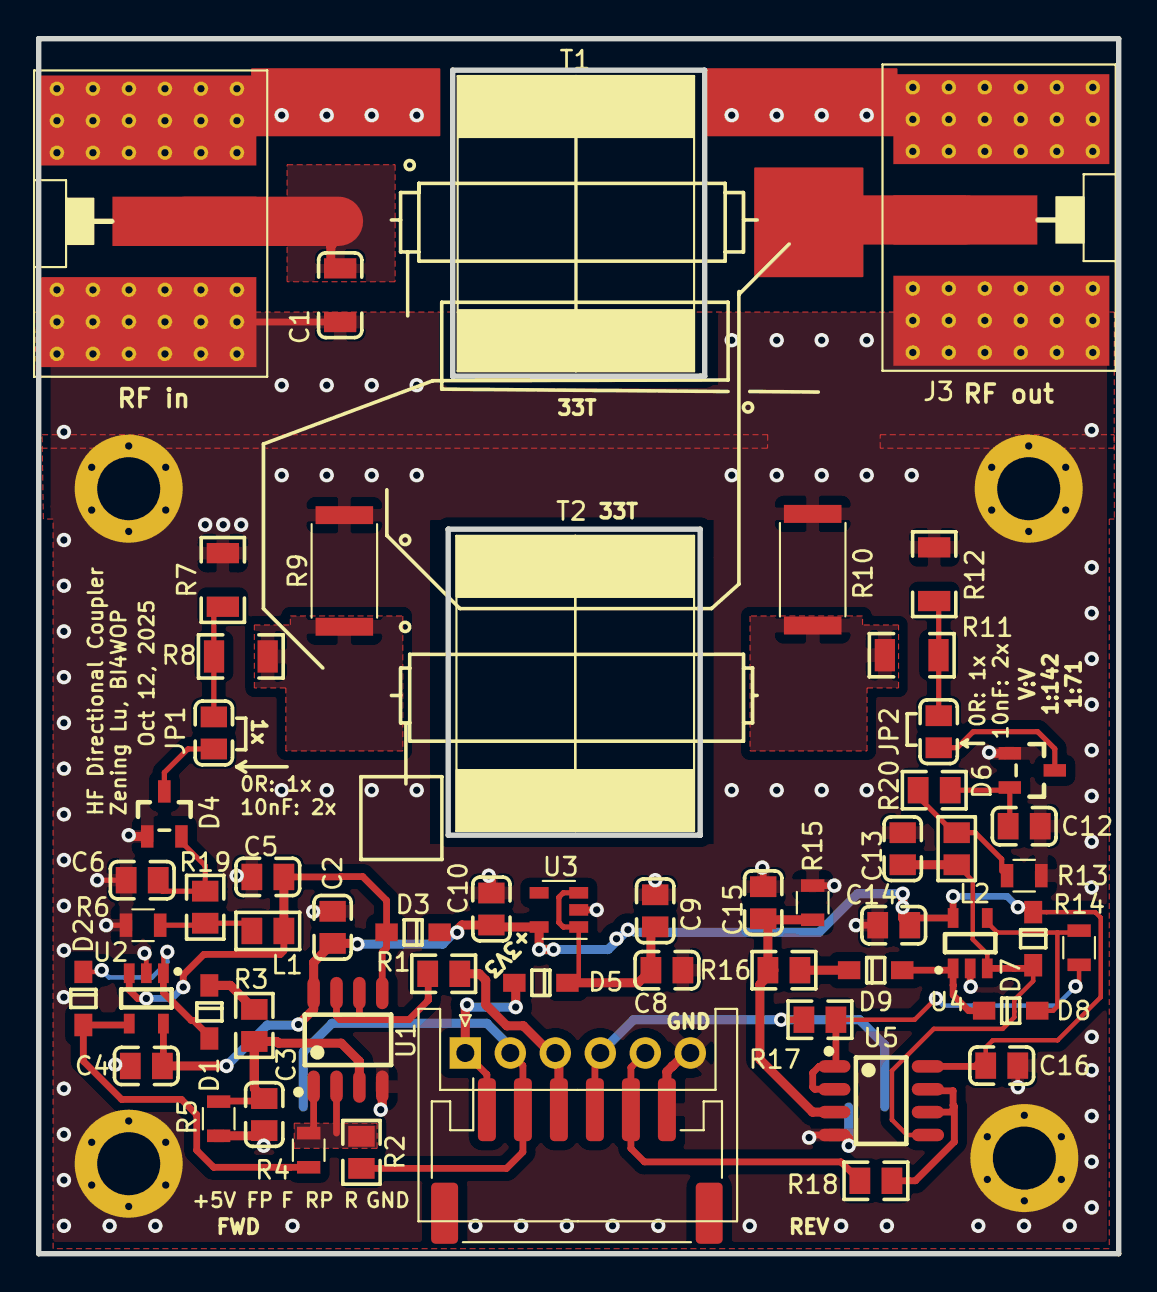
[picture p4: board Directional_coupler.kicad_pcb from above]

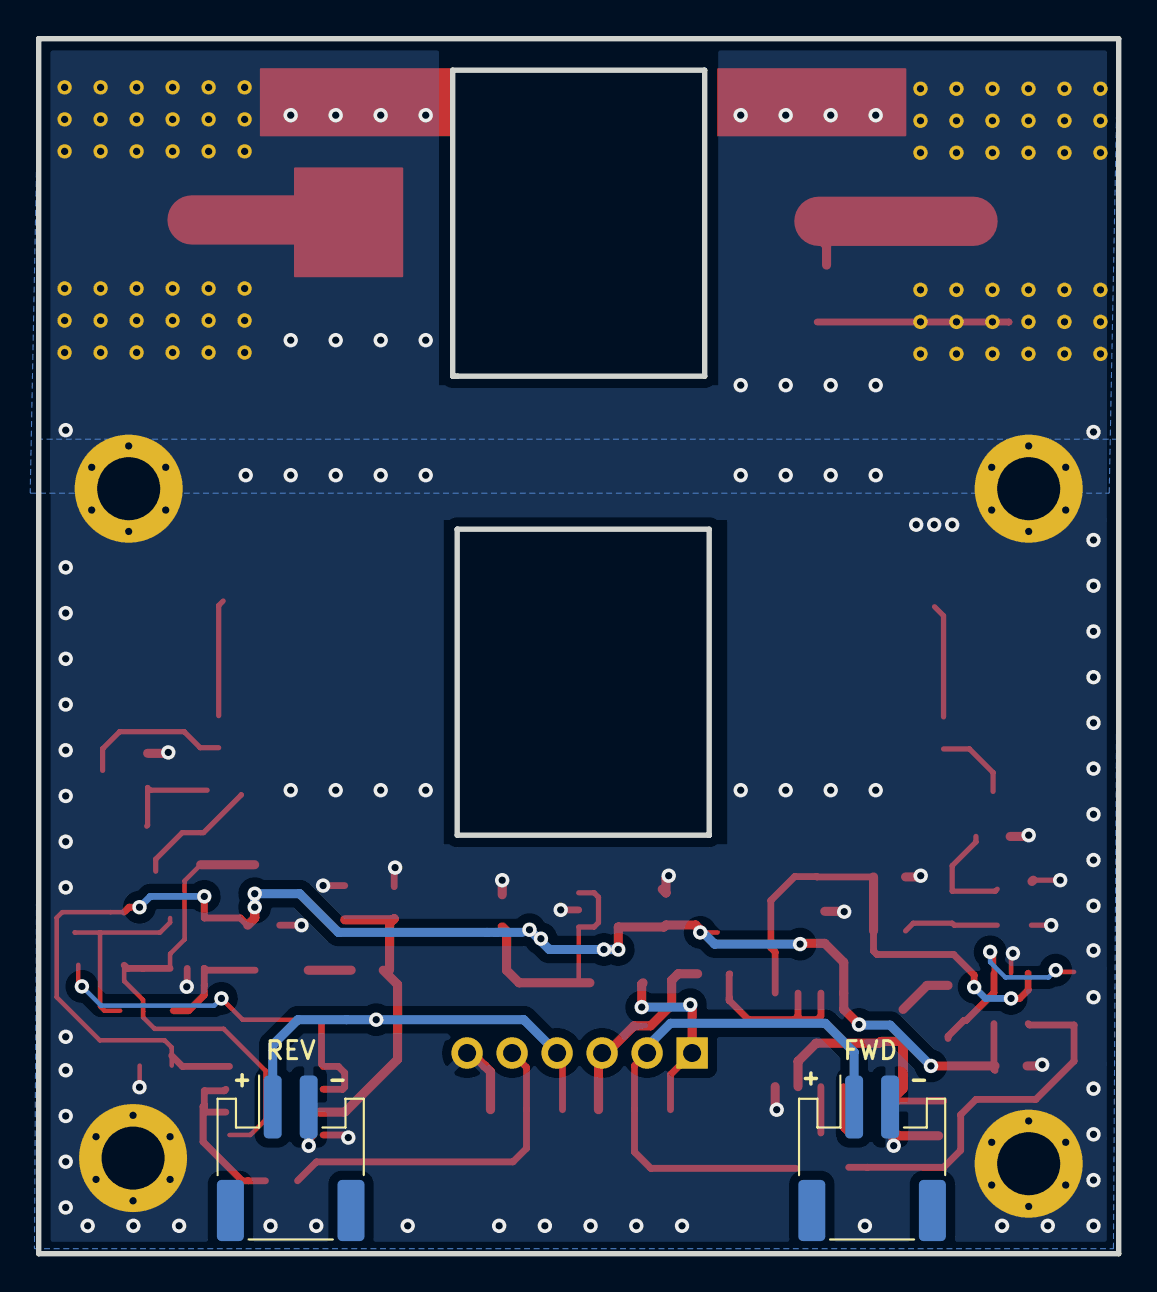
[picture p5: board Directional_coupler.kicad_pcb from below]

Board: 2 copper layers, 60.0 x 67.5 mm, 66 parts (2 on the bottom side), 33 nets.

Parts:
C1: 10p 1KV; 1206_C
C2, C4, C8, C14, C16: 104; 0805_C
C3, C9, C10, C15: 1uF; 0805_C
C5, C13: x; 0805_C
C6: 10n; 0805_C
C12: 10nF; 0805_C
D1, D2, D3, D5, D7, D8, D9: 1N5819; SOD-123
D4, D6: BAT54S; SOT-23(SOT-23-3)
J1: RF in; RF_conn_pad
J2: Singal; JST_XH_S06B-XH-A_06x2.50mm_Angled
J3: RF out; RF_conn_pad
J4: Singal; JST_PH_S6B-PH-SM4-TB_1x06-1MP_P2.00mm_Horizontal
J5: FWD; JST_PH_S2B-PH-SM4-TB_1x02-1MP_P2.00mm_Horizontal
J6: REV; JST_PH_S2B-PH-SM4-TB_1x02-1MP_P2.00mm_Horizontal
JP1, JP2: 10n; 0805_C
L1: 0Ohm; 0805_L
L2: 10uH; 0805_L
R1, R2, R3, R16, R17, R18: 100; 0805_R
R4, R14: 1K; R_0805
R5, R15: 1M; R_0805
R6, R13: 100K; R_0805
R7, R12: 330; 1206_R
R8, R11: 120; 1206_R
R9, R10: 56 2W; R_2512
R19, R20: 220K; 0805_R
SC1, SC2, SC3, SC4: GND; M3_Screwhole
T1, T1#2: 1T; 5943004901
T2, T2#2: 33T; 5943004901
U1, U5: GS8552; SOIC-8_150MIL
U2: TLV9001; SOT-23-5
U3: ME6211C33M5G-N; SOT-23-5
U4: RS8051; SOT-23-5

Connections:
+3V3: C2.2, C4.2, C10.1, C14.2, C16.2, D3.2, D7.2, U1.8, U2.5, U3.5, U4.5, U5.8
+5V: D5.1, J2.1, J4.1
FWD: J2.3, J4.3, R1.1
FWD_peak: J2.2, J4.2, J5.1, R2.1
GND: C1.1, C2.1, C3.2, C4.1, C5.1, C6.1, C8.1, C9.2, C10.2, C12.1, C13.2, C14.1, C15.2, C16.1, D4.1, D6.1, J1.2, J2.6, J3.2, J4.6, J5.2, J6.2, R5.1, R6.1, R7.1, R9.2, R10.2, R12.1, R13.1, R15.1, SC1.1, SC2.1, SC3.1, SC4.1, U1.4, U2.2, U3.2, U4.2, U5.4
unnamed: C1.2, J1.1
unnamed: C3.1, R3.1, R5.2, U1.3
unnamed: C5.2, D3.1, L1.1, U1.5, U2.3
unnamed: C6.2, D4.2, R19.2
unnamed: C8.2, C9.1, D5.2, U3.1, U3.3
unnamed: C12.2, D6.2, R20.2
unnamed: C13.1, D7.1, L2.2, U4.3, U5.5
unnamed: C15.1, R15.2, R16.2, U5.3
unnamed: D1.1, D2.2, U2.1
unnamed: D1.2, R3.2
unnamed: D2.1, R4.2, U2.4
unnamed: D4.3, JP1.2
unnamed: D6.3, JP2.1
unnamed: D8.1, R14.1, U4.4
unnamed: D8.2, D9.1, U4.1
unnamed: D9.2, R16.1
unnamed: JP1.1, R7.2, R8.2
unnamed: JP2.2, R11.1, R12.2
unnamed: L1.2, R6.2, R19.1
unnamed: L2.1, R13.2, R20.1
unnamed: R1.2, U1.6, U1.7
unnamed: R2.2, R4.1, U1.1, U1.2
unnamed: R8.1, R9.1
unnamed: R10.1, R11.2
unnamed: R14.2, R17.1, U5.1, U5.2
unnamed: R18.1, U5.6, U5.7
REV: J2.5, J4.5, R18.2
REV_peak: J2.4, J4.4, J6.1, R17.2
