LuZening/OPA2000/RF_2/OPA2000_RF/RF_output/RF_output.kicad_pcb

## KiCad design RF_2/OPA2000_RF/RF_output/RF_output.kicad_pcb (2026-10-17)

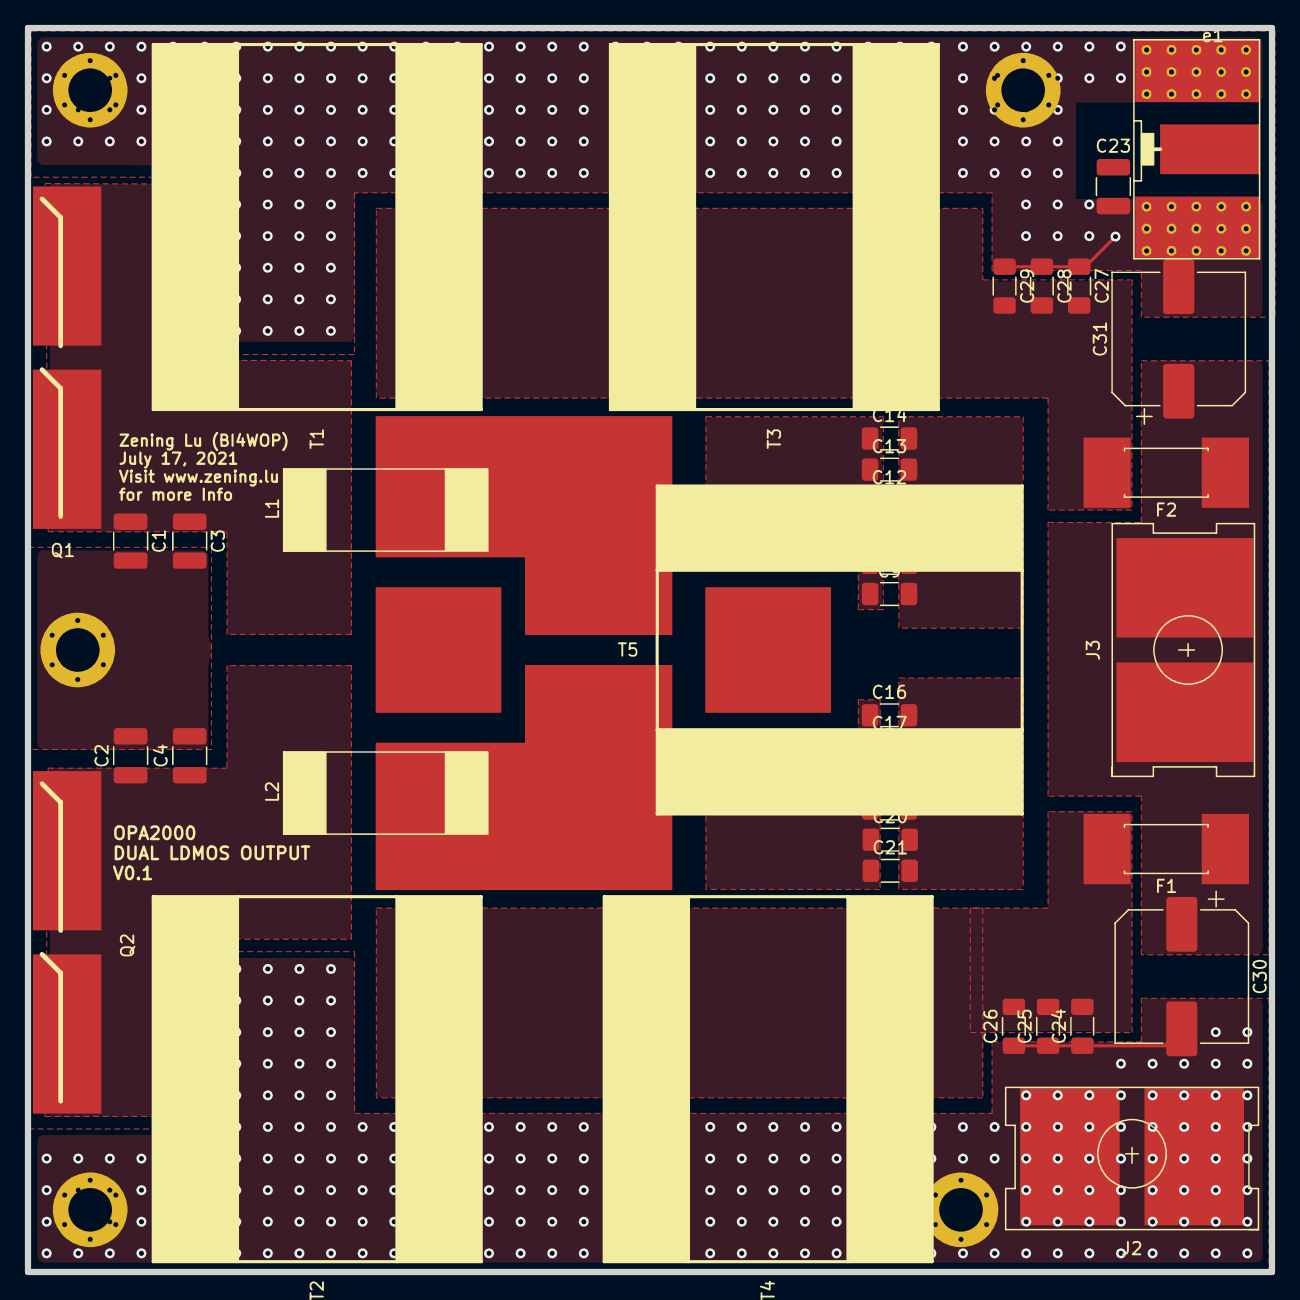
[picture p6: board RF_output.kicad_pcb from above]

Board: 2 copper layers, 100.0 x 100.0 mm, 44 parts (0 on the bottom side), 11 nets.

Parts:
C1, C2, C3, C4: 120pF; C_1210_3225Metric_Pad1.33x2.70mm_HandSolder
C9, C10, C11, C12, C13, C14, C16, C17, C18, C19, C20, C21, C24, C25, C26, C27, C28, C29: 103; C_1206_3216Metric_Pad1.33x1.80mm_HandSolder
C23: 30pF; C_1210_3225Metric_Pad1.33x2.70mm_HandSolder
C30, C31: 220uF 100V; CP_Elec_10x10.5
F1, F2: 30A; Fuseholder_Littelfuse_Nano2_456
J2: GND; PCB-10B-M4
J3: VDD in; PCB-10B-M4
L1, L2: Choke; 5943004901
Q1, Q2: BLF188XR
SC1, SC2, SC3, SC4, SC5: GND; M3_Screwhole
T1, T2, T3, T4, T5: TLT; Laird_28B1020_100
e1: Conn_Coaxial; RF_conn_pad_short

Connections:
GNDPWR: C1.2, C2.2, C3.2, C4.2, C23.2, C24.1, C25.1, C26.1, C27.1, C28.1, C29.1, C30.2, C31.2, J2.1, SC1.1, SC2.1, SC3.1, SC4.1, SC5.1, e1.2
unnamed: C1.1, C3.1, Q1.1, Q1.2
unnamed: C2.1, C4.1, Q2.1, Q2.2
unnamed: C9.1, C10.1, C11.1, C12.1, C13.1, C14.1
unnamed: C9.2, C10.2, C11.2, C12.2, C13.2, C14.2
unnamed: C16.1, C17.1, C18.1, C19.1, C20.1, C21.1
unnamed: C16.2, C17.2, C18.2, C19.2, C20.2, C21.2
unnamed: C23.1, e1.1
unnamed: C24.2, C25.2, C26.2, F1.2
unnamed: C27.2, C28.2, C29.2, F2.2
VDD: C30.1, C31.1, F1.1, F2.1, J3.1
