LuZening/OPA2000/Code_2/OPA2000_h7/User/Inc/opa2000.h

#define OPA2000_H
#ifdef __cplusplus
extern "C" {
#endif
#include <stdint.h>
#include <stdbool.h>
#include <string.h>
#include <stdio.h>
#include <stdlib.h>
#define ADC1_RANK_RF_IN        0U
#define ADC1_RANK_IM           1U
#define ADC1_RANK_REV1         2U
#define ADC1_RANK_FWD1         3U
#define ADC1_RANK_REV2         4U
#define ADC1_RANK_VBIAS        5U
#define ADC1_RANK_FWD2         6U
#define ADC1_RANK_VM           7U
#define ADC1_RANK_KEY_ADC      8U
#define ADC1_RANK_COUNT        9U
#define ADC2_RANK_IF_PA        0U
#define ADC2_RANK_IF_RADIO     1U
#define ADC2_INJ_NTC_CORE      0U
#define ADC2_INJ_NTC_AUX       1U
#define ADC2_INJ_TSENSE        2U
#define DEFAULT_PROTECT_REFLECT_POWER2_W     300
#define DEFAULT_PROTECT_REFLECT_POWER2_SWR   200
#define DEFAULT_PROTECT_SWR_THRESHOLD_X100   210
#define DEFAULT_PROTECT_REFLECT_POWER1_W     600
#define DEFAULT_PROTECT_MAIN_CURRENT_A       30
#define DEFAULT_PROTECT_NTC_TEMP_C           60
#define DEFAULT_PROTECT_TX_POWER1_W         1100
#define DEFAULT_PROTECT_TX_POWER2_W         1050
#define FAN_SPEED_50_PERCENT     50
#define FAN_SPEED_80_PERCENT     80
#define FAN_SPEED_100_PERCENT    100
#define FAN_TEMP_THRESHOLD_80    60
#define FAN_TEMP_THRESHOLD_100   70
#define FAN_HYSTERESIS           10
#define MAX_NTC_TEMP_C           70
#define MAX_TX_POWER1_W          1100
#define MAX_TX_POWER2_W          1050
#define MAX_MAIN_CURRENT_A       30
#ifdef OPA2000_NO_AWD
#else
#define USE_AWD
#endif
#ifdef OPA2000_NO_COMP
#else
#define USE_COMP
#endif
#define DAC_VDDA_MV                   3300U
#define DAC_FULL_SCALE                4095U
#define COMP1_REF_MV_MAX              3000U
#define COMP2_REF_MV_MAX              2500U
#define DEFAULT_COMP2_REF_MV          2442U
#define DEFAULT_COMP1_REF_MV          2378U
#define BAND_160M_MIN       1800000U
#define BAND_160M_MAX       2100000U
#define BAND_80M_MIN        3500000U
#define BAND_80M_MAX        3900000U
#define BAND_40M_30M_MIN    7000000U
#define BAND_40M_30M_MAX   10150000U
#define BAND_20M_17M_MIN   14000000U
#define BAND_20M_17M_MAX   18168000U
#define BAND_15M_10M_MIN   21000000U
#define BAND_15M_10M_MAX   29700000U
#define DEFAULT_PC_BAUD_RATE      115200U
#define DEFAULT_RADIO_BAUD_RATE   115200U
#define FREQDET_MULTIPLIER         10000U
#define FREQDET_MIN_VALID_FREQ_HZ  1000000U
#define FREQDET_MAX_VALID_FREQ_HZ 60000000U
#define BUZZER_NOTE_DURATION_MS    300U
#define BUZZER_NOTE_INTERVAL_MS    3000U
#define BUZZER_NOTE_HIGH_HZ        2500U
#define BUZZER_NOTE_MID_HZ         1500U
#define BUZZER_NOTE_LOW_HZ         800U
typedef enum {
    MULTILANG_CHINESE = 0,
    MULTILANG_ENGLISH,
} LanguageType;
typedef enum {
    RADIO_TYPE_UNKNOWN = 0,
    RADIO_TYPE_ICOM_CIV,
    RADIO_TYPE_YAESU,
    RADIO_TYPE_KENWOOD,
} RadioType;
typedef enum {
    BAND_NONE = 0,
    BAND_160M,
    BAND_80M,
    BAND_40M_30M,
    BAND_20M_17M,
    BAND_15M_10M,
    BAND_FAULT,
} BandType;
typedef enum {
    ALERT_NONE = 0,
    ALERT_SWR_HIGH,
    ALERT_REFLECT_POWER_HIGH,
    ALERT_CURRENT_HIGH,
    ALERT_HARDWARE_FAULT,
    ALERT_OVERDRIVE,
    ALERT_FREQ_MISMATCH,
    ALERT_NTC_OVERHEAT,
    ALERT_VBIAS_FAULT,
    ALERT_FAN_FAULT,
} AlertType;
typedef enum {
    ALERT_SEV_NONE = 0,
    ALERT_SEV_P0,
    ALERT_SEV_P1,
} AlertSeverity;
typedef enum {
    FAN_SPEED_LOW = 0,
    FAN_SPEED_MED,
    FAN_SPEED_HIGH,
} FanSpeedType;
typedef enum {
    POWER_STATE_OFF = 0,
    POWER_STATE_STANDBY,
    POWER_STATE_TX,
} PowerStateType;
typedef struct {
    const char *zh;
    const char *en;
} MultiLangStr;
typedef struct {
    volatile uint16_t adc1_raw[ADC1_RANK_COUNT];
    volatile uint16_t adc2_if_pa_raw;
    volatile uint16_t adc2_if_radio_raw;
    volatile uint16_t adc2_inj_ntc_core_raw;
    volatile uint16_t adc2_inj_ntc_aux_raw;
    volatile uint16_t adc2_inj_tsense_raw;
    volatile int32_t im_mA;
    volatile int32_t vm_mV;
    volatile int32_t fwd1_mW;
    volatile int32_t fwd2_mW;
    volatile int32_t rev1_mW;
    volatile int32_t rev2_mW;
    volatile int32_t rf_in_mW;
    volatile int32_t vbias_mV;
    volatile int32_t ntc_core_tenth_c;
    volatile int32_t ntc_aux_tenth_c;
    volatile int32_t mcu_int_tenth_c;
    volatile uint16_t key_adc;
    volatile int32_t swr_x100;
    volatile int32_t fwd2_peak_mW;
    volatile int32_t rev2_peak_mW;
    volatile uint32_t seq;
} AdcDataType;
typedef struct {
    float    x_gain;
    float    x_offset;
    float    y_gain;
    float    y_offset;
    uint8_t  calibrated;
    uint8_t  reserved[3];
} touch_cal_t;
typedef struct {
    int32_t  gain_uW_per_code;
    int32_t  offset_mW;
} coupler_t;
typedef struct {
    uint32_t magic;
    uint8_t  version;
    uint8_t  reserved0[3];
    uint32_t pc_baud_rate;
    RadioType radio_type;
    uint32_t radio_baud_rate;
    uint16_t band_rf_in_max_w[6];
    uint16_t band_rev1_max_w;
    uint16_t band_rev2_max_w;
    uint16_t band_rev2_swr_w;
    uint16_t band_swr_max_x100;
    uint16_t band_ntc_max_tenth_c;
    uint16_t band_fwd1_max_w;
    uint16_t band_fwd2_max_w;
    uint16_t band_im_max_mA;
    uint16_t band_vbias_max_mV;
    uint16_t comp1_ref_mV;
    uint16_t comp2_ref_mV;
    uint16_t im_zero_offset_adc;
    uint8_t  im_calibrated;
    touch_cal_t touch;
    coupler_t fwd1;
    coupler_t fwd2;
    coupler_t rev1;
    coupler_t rev2;
    LanguageType language;
    uint8_t  buzzer_enable;
    uint8_t  temp_fahrenheit;
    uint8_t  allow_protection;
    uint8_t  im_sensor_type;
    uint8_t  reserved[3];
    uint32_t crc32;
} ConfigType;
#define IM_SENSOR_UNKNOWN        0U
#define IM_SENSOR_BIDIRECTIONAL   1U
#define IM_SENSOR_UNIDIRECTIONAL  2U
extern volatile AdcDataType    g_adc_data;
extern volatile bool           g_psu_on;
extern volatile bool           g_hv_on;
extern volatile bool           g_tx_active;
extern volatile BandType       g_current_band;
extern volatile bool           g_allow_rf;
extern volatile AlertType      g_alert_active;
extern volatile AlertSeverity  g_alert_severity;
extern volatile bool           g_alert_flag;
extern volatile FanSpeedType   g_fan_speed;
extern volatile uint32_t       g_radio_freq_hz;
extern volatile PowerStateType g_power_state;
extern volatile ConfigType g_config;
extern volatile bool g_calibration_required;
extern volatile bool g_touch_calibrated;
extern volatile bool g_gui_ready;
extern volatile bool g_ptt_ready;
extern volatile uint32_t g_freertos_fault;
extern const char *strFreqRanges[];
extern const char *strBands[];
uint32_t crc32_calculate(const uint8_t *data, uint32_t length);
BandType frequency_to_band(uint32_t frequency_hz);
int32_t  calculate_swr_x100(int32_t fwd2_mW, int32_t rev2_mW);
AlertSeverity alert_severity(AlertType a);
void opa2000_init(void);
#ifdef __cplusplus
}
#endif
