LuZening/OPA2000/Code_2/OPA2000_h7/OPA2000_h7.ioc

Mcu.UserName=STM32H7B0ZBTx
PA0.Signal=ADC1_INP16
PA1.Signal=ADC1_INP17
PA10.Signal=LTDC_B4
PA11.Signal=USB_OTG_HS_DM
PA12.Signal=USB_OTG_HS_DP
PA13.Signal=DEBUG_JTMS-SWDIO
PA14.Signal=DEBUG_JTCK-SWCLK
PA15.Signal=LTDC_R3
PA2.Signal=ADCx_INP14
PA3.Signal=ADC1_INP15
PA4.Signal=LTDC_VSYNC
PA5.Signal=LTDC_R4
PA6.Signal=LTDC_G2
PA7.Signal=SPI1_MOSI
PA8.Signal=I2C3_SCL
PA9.Signal=USB_OTG_HS_VBUS
PB0.Signal=ADCx_INP9
PB1.Signal=ADCx_INP5
PB10.Signal=LTDC_G4
PB11.GPIO_Label=LO_BASE_CLK
PB11.Signal=S_TIM2_CH4
PB12.GPIO_Label=HARDPWR_ERR
PB12.Signal=GPXTI12
PB13.GPIO_Label=RF_IN_PROTECT_CPU_SIG
PB13.Signal=GPIO_Output
PB14.Signal=SDMMC2_D0
PB15.Signal=SDMMC2_D1
PB2.Signal=COMP1_INP
PB3.Signal=SDMMC2_D2
PB4.Signal=SPI6_MISO
PB5.Signal=LTDC_B5
PB6.Signal=LPUART1_TX
PB7.Signal=LPUART1_RX
PB8.Signal=LTDC_B6
PB9.GPIO_Label=LIGHTNING_PROTECTION_A
PB9.Signal=GPIO_Output
PC0.Signal=LTDC_R5
PC1.Signal=LTDC_G5
PC10.Signal=UART4_TX
PC11.Signal=UART4_RX
PC12.Signal=LTDC_R6
PC13.GPIO_Label=KEY1_WKUP
PC13.Signal=PWR_WKUP4
PC14-OSC32_IN.GPIO_Label=LPF6
PC14-OSC32_IN.Signal=GPIO_Output
PC15-OSC32_OUT.GPIO_Label=PTT_OUT
PC15-OSC32_OUT.Signal=GPIO_Output
PC2_C.Signal=ADC2_INP0
PC3_C.Signal=ADC2_INP1
PC4.Signal=ADCx_INP4
PC5.Signal=ADCx_INP8
PC6.Signal=LTDC_HSYNC
PC7.Signal=LTDC_G6
PC8.GPIO_Label=FAN1_PWM
PC8.Signal=S_TIM3_CH3
PC9.Signal=I2C3_SDA
PD0.Signal=FDCAN1_RX
PD1.Signal=FDCAN1_TX
PD10.Signal=LTDC_B3
PD11.Signal=SAI2_SD_A
PD12.Signal=SAI2_FS_A
PD13.Signal=SAI2_SCK_A
PD14.GPIO_Label=BL_PWM
PD14.Signal=S_TIM4_CH3
PD15.GPIO_Label=PUMP_PWM
PD15.Signal=S_TIM4_CH4
PD2.Signal=LTDC_B7
PD3.Signal=LTDC_G7
PD4.GPIO_Label=FAN1_SENSEX
PD4.Signal=GPIO_Input
PD5.GPIO_Label=PUMP_SENSEX
PD5.Signal=GPIO_Input
PD6.Signal=SDMMC2_CK
PD7.Signal=SDMMC2_CMD
PD8.GPIO_Label=CPU_READY
PD8.Signal=GPIO_Output
PD9.GPIO_Label=LIGHTNING_PROTECTION_B
PD9.Signal=GPIO_Output
PE0.Signal=SAI2_MCLK_A
PE1.GPIO_Label=LPF1
PE1.Signal=GPIO_Output
PE10.GPIO_Label=TFT_DISP
PE10.Signal=GPIO_Output
PE11.Signal=LTDC_G3
PE12.Signal=COMP1_OUT
PE13.Signal=LTDC_DE
PE14.Signal=LTDC_CLK
PE15.Signal=LTDC_R7
PE2.GPIO_Label=LPF2
PE2.Signal=GPIO_Output
PE3.GPIO_Label=LPF3
PE3.Signal=GPIO_Output
PE4.GPIO_Label=LPF4
PE4.Signal=GPIO_Output
PE5.GPIO_Label=LPF5
PE5.Signal=GPIO_Output
PE6.GPIO_Label=BUZZER
PE6.Signal=S_TIM15_CH2
PE7.GPIO_Label=ETR_FREQDET
PE7.Signal=S_TIM1_ETR
PE8.Signal=COMP2_OUT
PE9.Signal=COMP2_INP
PF0.Signal=I2C2_SDA
PF1.Signal=I2C2_SCL
PF10.Signal=OCTOSPIM_P1_CLK
PF11.Signal=SAI2_SD_B
PF12.Signal=ADC1_INP6
PF13.Signal=ADC2_INP2
PF14.Signal=ADC2_INP6
PF15.GPIO_Label=BACKUP_POWEREDX
PF15.Signal=GPXTI15
PF2.GPIO_Label=CTouch_INTX
PF2.Signal=GPXTI2
PF3.GPIO_Label=CTouch_RSTX
PF3.Signal=GPIO_Output
PF4.GPIO_Label=REAR_RESERVED1
PF4.Signal=GPIO_Output
PF5.GPIO_Label=PTT_INX
PF5.Signal=GPXTI5
PF6.Signal=OCTOSPIM_P1_IO3
PF7.Signal=OCTOSPIM_P1_IO2
PF8.Signal=OCTOSPIM_P1_IO0
PF9.Signal=OCTOSPIM_P1_IO1
PG0.GPIO_Label=ALC_PWM_OUT
PG0.Signal=GPIO_Output
PG1.GPIO_Label=CLEAR_FAULTX_OC
PG1.Signal=GPIO_Output
PG10.Signal=SPI1_NSS
PG11.Signal=SPI1_SCK
PG12.Signal=SDMMC2_D3
PG13.Signal=SPI6_SCK
PG14.Signal=SPI6_MOSI
PG15.GPIO_Label=SDMMC2_CD
PG15.Signal=GPIO_Input
PG2.GPIO_Label=RF_BIAS_ON
PG2.Signal=GPIO_Output
PG3.GPIO_Label=RELAY2
PG3.Signal=GPIO_Output
PG4.GPIO_Label=RELAY1
PG4.Signal=GPIO_Output
PG5.GPIO_Label=MAIN_PSU_ON_SIG
PG5.Signal=GPIO_Output
PG6.Signal=OCTOSPIM_P1_NCS
PG7.GPIO_Label=PWR_ON_SIG
PG7.Signal=GPIO_Output
PG8.Signal=SPI6_NSS
PG9.Signal=SPI1_MISO
PH0-OSC_IN.Signal=RCC_OSC_IN
PH1-OSC_OUT.Signal=RCC_OSC_OUT
