LuZening/OPA2000/Code_2/OPA2000_h7/User/Inc/hw_pinmap.h

/**
 * @file    hw_pinmap.h
 * @brief   Hardware pin/port macros for OPA2000 H7 Control firmware
 *
 * @details This header centralises every GPIO pin, ADC channel rank, timer
 *          channel and external IRQ that the firmware touches.  All source
 *          files (Control / GUI / Networking) include this header rather
 *          than redefining the pinout locally.
 *
 *          Reference: OPA2000_h7.ioc + lceda Control schematic
 *          (U5 = STM32H7B0ZBT6 LQFP144).  Cross-checked against
 *          .trae/all_nets.json 2026-10.
 *
 *          ----------------------------------------------------------------
 *          引脚号的真相源是 CubeMX，不要在这里硬编码
 *          ----------------------------------------------------------------
 *          CubeMX 只为它自己配置的引脚生成宏，落在 Core/Inc/main.h。
 *          分工如下：
 *
 *            - 已由 ioc 生成的（GPIO 输出/输入，如 LPF1..6、RELAY1/2、
 *              PWR_ON、RF_BIAS、PSU、PTT_IN/OUT、BL_PWM …）：**真相源是
 *              main.h**。本文件里对应的 *_Pin / *_GPIO_Port 一律写成
 *              别名（`#define X_Pin  main.h 里的名字`），不重复写死数值。
 *              这样在 CubeMX 里改引脚后重新生成，固件自动跟随；编译器
 *              也会在名字对不上时直接报错，而不是静默操作错误的脚。
 *
 *            - CubeMX 不产生的（定时器通道、ADC rank、AWD 通道、EXTI
 *              中断号、DAC 通道、以及 LPUART1 / UART4 / I2C2 / USB /
 *              SDMMC2 / FDCAN1 / SPI6 这些外设引脚）：真相源是本文件。
 *              CubeMX 对这些外设不生成宏，固件只能自己声明。
 *
 *          历史上本文件把前者也硬编码了一遍，于是出现了"同名不同名"的
 *          两套宏（如 PWR_ON_Pin 与 PWR_ON_SIG_Pin）。两套宏名字不同，
 *          #ifndef 保护对它们无效，编译不报错，ioc 改了引脚也不会有人
 *          提醒 —— 那才是真正危险的地方。现在统一成别名。
 *
 *          DO NOT MODIFY without updating both ioc and the firmware
 *          design spec.  The MCU is U5 in the schematic (not U1).
 *
 * @version 1.0
 * @date    2026-10
 * @author  Control Agent (wt-control branch)
 */

#ifndef HW_PINMAP_H
#define HW_PINMAP_H

/* LVGL v7 PC simulator builds have no CMSIS / HAL; skip the include and
 * leave the pin-macros (which are just GPIOX / GPIO_PIN_y) available as
 * raw identifiers for SIM-only paths.  Same guard as in lv_port_disp.c,
 * gui.c, opa2000.h, etc. — see docs/SIMULATOR_GUIDE.md §2 for context. */
#ifndef LVGL_SIM
#include "stm32h7xx_hal.h"
/* main.h is the CubeMX-generated pin assignment.  It has to come in here
 * rather than relying on every consumer to include it first: the short
 * names below are aliases onto macros defined there, and an alias whose
 * target is undefined silently expands to nothing. */
#include "main.h"
#endif

#ifdef __cplusplus
extern "C" {
#endif

/* ===========================================================================
 *  1. MCU identification
 * ===========================================================================*/
#define OPA2000_MCU_NAME         "STM32H7B0ZBT6"
#define OPA2000_MCU_DESIGNATOR   "U5"   /*!< lceda schematic designator */

/* ===========================================================================
 *  2. LPF band switching (HIGH-ACTIVE, LPF1 .. LPF6)
 *
 *  LPFn_Pin / LPFn_GPIO_Port are generated by CubeMX into Core/Inc/main.h
 *  and are therefore the single source of truth - this file only adds the
 *  active-level helper.  The #ifndef fallback below exists solely for the
 *  host unit-test build, where main.h is replaced by
 *  User/Tests/stubs/main.h.
 *
 *  ioc / main.h assignment:
 *      LPF1 = PE1  (R45  -> H3-2)
 *      LPF2 = PE2  (R50  -> H3-3)
 *      LPF3 = PE3  (R51  -> H3-4)
 *      LPF4 = PE4  (R61  -> H3-5)
 *      LPF5 = PE5  (R62  -> H3-6)
 *      LPF6 = PC14 (R105 -> H3-7)
 *
 *  Band -> LPF mapping (lower index == shorter wavelength):
 *      LPF1 = 15-10 m
 *      LPF2 = 20-17 m
 *      LPF3 = 40-30 m
 *      LPF4 = 80 m
 *      LPF5 = 160 m
 *      LPF6 = spare (only 5 combined bands exist)
 *
 *  The mapping itself lives in switch_band() (power_control.c).
 * ===========================================================================*/
#ifndef LPF1_Pin
#define LPF1_GPIO_Port   GPIOE
#define LPF1_Pin         GPIO_PIN_1
#define LPF2_GPIO_Port   GPIOE
#define LPF2_Pin         GPIO_PIN_2
#define LPF3_GPIO_Port   GPIOE
#define LPF3_Pin         GPIO_PIN_3
#define LPF4_GPIO_Port   GPIOE
#define LPF4_Pin         GPIO_PIN_4
#define LPF5_GPIO_Port   GPIOE
#define LPF5_Pin         GPIO_PIN_5
#define LPF6_GPIO_Port   GPIOC
#define LPF6_Pin         GPIO_PIN_14
#endif /* !LPF1_Pin */
/*! LPF is high-active: SET the corresponding pin to enable the band relay. */
#define LPF_ACTIVE(level)       ((level) ? GPIO_PIN_SET : GPIO_PIN_RESET)

/* ===========================================================================
 *  3. Power / relay control
 *
 *  All six groups below alias the CubeMX-generated names in main.h rather
 *  than repeating the pin numbers.  The aliases exist purely so the rest of
 *  the firmware keeps its short names; the pin assignment itself lives in
 *  OPA2000_h7.ioc.  Re-generating from the ioc therefore moves the pin and
 *  every user follows, with no chance of a silent mismatch.
 * ===========================================================================*/

/* RELAY1 (PG4): high-active, drives Q1 low-side to enable main PSU.
 * RELAY1_Pin / RELAY1_GPIO_Port come straight from main.h (same name). */
#define RELAY1_ON()       HAL_GPIO_WritePin(RELAY1_GPIO_Port, RELAY1_Pin, GPIO_PIN_SET)
#define RELAY1_OFF()      HAL_GPIO_WritePin(RELAY1_GPIO_Port, RELAY1_Pin, GPIO_PIN_RESET)

/* RELAY2 (PG3): high-active, drives Q2 low-side for +12V output.
 * RELAY2_Pin / RELAY2_GPIO_Port come straight from main.h (same name). */
#define RELAY2_ON()       HAL_GPIO_WritePin(RELAY2_GPIO_Port, RELAY2_Pin, GPIO_PIN_SET)
#define RELAY2_OFF()      HAL_GPIO_WritePin(RELAY2_GPIO_Port, RELAY2_Pin, GPIO_PIN_RESET)

/* MAIN_PSU_ON_SIG (PG5): high-to-power-on, low-to-power-off (via Q9 inverting into PC13).
 * CubeMX calls it MAIN_PSU_ON_SIG; alias down to the short name. */
#define PSU_ON_GPIO_Port  MAIN_PSU_ON_SIG_GPIO_Port
#define PSU_ON_Pin        MAIN_PSU_ON_SIG_Pin
#define PSU_ON_PWR_ON()    HAL_GPIO_WritePin(PSU_ON_GPIO_Port, PSU_ON_Pin, GPIO_PIN_SET)
#define PSU_ON_PWR_OFF()   HAL_GPIO_WritePin(PSU_ON_GPIO_Port, PSU_ON_Pin, GPIO_PIN_RESET)

/* PWR_ON_SIG (PG7): high-active, drives H1-2 (high-voltage power supply enable).
 * CubeMX calls it PWR_ON_SIG; alias down to the short name. */
#define PWR_ON_GPIO_Port   PWR_ON_SIG_GPIO_Port
#define PWR_ON_Pin         PWR_ON_SIG_Pin
#define PWR_ON_ENABLE()    HAL_GPIO_WritePin(PWR_ON_GPIO_Port, PWR_ON_Pin, GPIO_PIN_SET)
#define PWR_ON_DISABLE()   HAL_GPIO_WritePin(PWR_ON_GPIO_Port, PWR_ON_Pin, GPIO_PIN_RESET)

/* RF_BIAS_ON (PG2): high-active, drives R47 -> H5-3 PA bias enable.
 * CubeMX calls it RF_BIAS_ON; alias down to the short name. */
#define RF_BIAS_GPIO_Port  RF_BIAS_ON_GPIO_Port
#define RF_BIAS_Pin        RF_BIAS_ON_Pin
#define RF_BIAS_ENABLE()   HAL_GPIO_WritePin(RF_BIAS_GPIO_Port, RF_BIAS_Pin, GPIO_PIN_SET)
#define RF_BIAS_DISABLE()  HAL_GPIO_WritePin(RF_BIAS_GPIO_Port, RF_BIAS_Pin, GPIO_PIN_RESET)

/* HARDPWR_ERR (PB12): EXTI12 rising edge, hardware fault from supply.
 * HARDPWR_ERR_GPIO_Port / HARDPWR_ERR_Pin come straight from main.h. */

/* RF_IN_PROTECT_CPU_SIG (PB13): fault output (push-pull, pull to high).
 * CubeMX calls it RF_IN_PROTECT_CPU_SIG; alias down to the short name. */
#define RF_IN_PROTECT_GPIO_Port  RF_IN_PROTECT_CPU_SIG_GPIO_Port
#define RF_IN_PROTECT_Pin        RF_IN_PROTECT_CPU_SIG_Pin
#define RF_IN_PROTECT_RAISE()   HAL_GPIO_WritePin(RF_IN_PROTECT_GPIO_Port, RF_IN_PROTECT_Pin, GPIO_PIN_SET)
#define RF_IN_PROTECT_CLEAR()   HAL_GPIO_WritePin(RF_IN_PROTECT_GPIO_Port, RF_IN_PROTECT_Pin, GPIO_PIN_RESET)

/* CLEAR_FAULTX_OC (PG1): GPIO output, open-drain (GPIO_MODE_OUTPUT_OD),
 * wired to C65-2 / D10-1 / R71-1.  Open-drain means the pin can only pull
 * the net down - it cannot drive it high.  So:
 *
 *   LOW  = the pin pulls the net low  -> the external fault latch is held
 *          in its cleared state and no latched alarm survives.
 *   HIGH = the output stage is released -> the net floats back to its
 *          pull-up and the latch works normally again.
 *
 * Written HIGH at the end of MX_GPIO_Init(), i.e. the reset state is
 * "normal operation"; boot then drives it LOW for the whole power-on
 * stabilisation window (see adc_stabilisation_tick() in user_adc.c) and
 * releases it only once the readings are trustworthy.
 *
 * CLEAR_FAULTX_OC_GPIO_Port / CLEAR_FAULTX_OC_Pin come straight from
 * main.h (PG1), so no alias is needed. */
#define CLEAR_FAULTX_OC_LOW()   HAL_GPIO_WritePin(CLEAR_FAULTX_OC_GPIO_Port, CLEAR_FAULTX_OC_Pin, GPIO_PIN_RESET)
#define CLEAR_FAULTX_OC_HIGH()  HAL_GPIO_WritePin(CLEAR_FAULTX_OC_GPIO_Port, CLEAR_FAULTX_OC_Pin, GPIO_PIN_SET)

/* CPU_READY (PD8): GPIO output (status indication).
 * CPU_READY_GPIO_Port / CPU_READY_Pin come straight from main.h. */

/* TFT_DISP (PE10): LTDC panel "display enable" line.  HIGH = the panel's
 * source driver and gate driver come out of standby and accept the LTDC
 * pixel stream.  LOW = blanked, no power wasted in the panel's row/col
 * drivers.  Driven HIGH only once the GUI has painted its first frame
 * (g_gui_ready), via boot_backlight_on() in boot.c.  Drawn LOW again on
 * power_soft_off() so the panel darkens in step with the supply.
 *
 * TFT_DISP_GPIO_Port / TFT_DISP_Pin come straight from main.h (PE10), same
 * as the other CubeMX-named pins above - no alias needed.
 *
 * Polarity assumption: HIGH enables.  This matches the ST RGB-LCD
 * reference design and most third-party panels with a "DISP" pin.  If
 * a particular panel uses active-low DISP, invert both macros. */
#define TFT_DISP_ENABLE()    HAL_GPIO_WritePin(TFT_DISP_GPIO_Port, TFT_DISP_Pin, GPIO_PIN_SET)
#define TFT_DISP_DISABLE()   HAL_GPIO_WritePin(TFT_DISP_GPIO_Port, TFT_DISP_Pin, GPIO_PIN_RESET)

/* LIGHTNING_PROTECTION_A / B (PB9 / PD9): GPIO outputs, jumper pads.
 * CubeMX names them LIGHTNING_PROTECTION_A / _B; alias down. */
#define LIGHTNING_A_GPIO_Port  LIGHTNING_PROTECTION_A_GPIO_Port
#define LIGHTNING_A_Pin        LIGHTNING_PROTECTION_A_Pin
#define LIGHTNING_B_GPIO_Port  LIGHTNING_PROTECTION_B_GPIO_Port
#define LIGHTNING_B_Pin        LIGHTNING_PROTECTION_B_Pin

/* ===========================================================================
 *  4. PTT keying
 * ===========================================================================*/
/* PTT_INX (PF5): EXTI5 input from the radio / footswitch, ACTIVE LOW.
 * A low level means "transmit requested".
 * CubeMX names it PTT_INX; alias down to the short name. */
#define PTT_IN_GPIO_Port   PTT_INX_GPIO_Port
#define PTT_IN_Pin         PTT_INX_Pin
#define PTT_IN_ACTIVE_LOW  1

/* PTT_OUT (PC15): keying feedback back to the radio, ACTIVE HIGH.
 * Driven high once the amplifier is actually passing RF, i.e. after the
 * 15 ms break-before-make delay has closed RELAY1.  Dropped immediately
 * (no delay) whenever the state machine leaves PTT_STATE_TX_RUNNING or
 * protection trips.
 * PTT_OUT_Pin / PTT_OUT_GPIO_Port come straight from main.h. */
#define PTT_OUT_ON()       HAL_GPIO_WritePin(PTT_OUT_GPIO_Port, PTT_OUT_Pin, GPIO_PIN_SET)
#define PTT_OUT_OFF()      HAL_GPIO_WritePin(PTT_OUT_GPIO_Port, PTT_OUT_Pin, GPIO_PIN_RESET)

/* KEY1_WKUP (PC13): PWR_WKUP4, EXTI13 reserved for wake-up.
 * KEY1_WKUP_GPIO_Port / KEY1_WKUP_Pin come straight from main.h. */

/* ===========================================================================
 *  5. Fan / pump control
 *
 *  Pin macros come from main.h (same names).  What CubeMX does NOT generate
 *  is the timer channel binding, so those are declared here.
 * ===========================================================================*/
/* FAN1_PWM (PC8): TIM3_CH3, 10kHz, high-active */
#define FAN1_PWM_TIM_INSTANCE  TIM3
#define FAN1_PWM_TIM_CHANNEL  TIM_CHANNEL_3

/* PUMP_PWM (PD15): TIM4_CH4, 10kHz, high-active */
#define PUMP_PWM_TIM_INSTANCE TIM4
#define PUMP_PWM_TIM_CHANNEL TIM_CHANNEL_4

/* BL_PWM (PD14): TIM4_CH3, backlight PWM */
#define BL_PWM_TIM_INSTANCE TIM4
#define BL_PWM_TIM_CHANNEL TIM_CHANNEL_3

/* FAN1_SENSEX (PD4): GPIO input, TACH feedback from fan FG pin.
 * CubeMX names it FAN1_SENSEX; alias down to the short name. */
#define FAN1_SENSE_GPIO_Port  FAN1_SENSEX_GPIO_Port
#define FAN1_SENSE_Pin        FAN1_SENSEX_Pin

/* PUMP_SENSEX (PD5): GPIO input, TACH feedback from pump FG pin.
 * CubeMX names it PUMP_SENSEX; alias down to the short name. */
#define PUMP_SENSE_GPIO_Port  PUMP_SENSEX_GPIO_Port
#define PUMP_SENSE_Pin        PUMP_SENSEX_Pin

/* ===========================================================================
 *  6. Buzzer (TIM15_CH2 state machine, no DMA)
 * ===========================================================================*/
#define BUZZER_TIM_INSTANCE TIM15
#define BUZZER_TIM_CHANNEL TIM_CHANNEL_2

/* ===========================================================================
 *  7. ALC PWM (TIM2 OC + DMA -> PG0 BSRR, ~200kHz)
 *
 *  CubeMX calls the pin ALC_PWM_OUT; alias down to the short name.
 * ===========================================================================*/
#define ALC_PWM_GPIO_Port   ALC_PWM_OUT_GPIO_Port
#define ALC_PWM_Pin         ALC_PWM_OUT_Pin
#define ALC_PWM_TIM_INSTANCE TIM2
#define ALC_PWM_TIM_CHANNEL_RISE TIM_CHANNEL_1   /* CCR1 -> BSRR set bit 0 */
#define ALC_PWM_TIM_CHANNEL_FALL TIM_CHANNEL_2   /* CCR2 -> BSRR reset bit 0 */

/* ===========================================================================
 *  8. ETR frequency detect (TIM1 ETR mode 2)
 * ===========================================================================*/
#define ETR_FREQDET_TIM_INSTANCE TIM1
#define ETR_FREQDET_PRESCALER  31U
#define ETR_FREQDET_SAMPLE_PERIOD_US 100U

/* ===========================================================================
 *  9. I2C bus + touch controller (used by GUI agent too)
 *
 *  I2C2 lives on PF0/PF1, which CubeMX does NOT currently have configured as
 *  I2C2 in the .ioc, so no macros are generated for it - this file is the
 *  source of truth.  Same for the touch signals below.
 * ===========================================================================*/
#define I2C2_SCL_GPIO_Port   GPIOF
#define I2C2_SCL_Pin         GPIO_PIN_1
#define I2C2_SDA_GPIO_Port   GPIOF
#define I2C2_SDA_Pin         GPIO_PIN_0
#define I2C2_INSTANCE        I2C2

/* PF4 / PF5 / PF3 = GPIO; LCT_INT on PF2 (EXTI2 for GT911 only).
 * REAR_RESERVED1, CTouch_RSTX and CTouch_INTX come from main.h (same names).
 * RTouch_PENIRQX_NOW is a legacy alias of REAR_RESERVED1 (both PF4). */
#define RTouch_PENIRQX_NOW_GPIO_Port REAR_RESERVED1_GPIO_Port
#define RTouch_PENIRQX_NOW_Pin       REAR_RESERVED1_Pin

/* ===========================================================================
 * 10. Communication bus pin allocation
 * ===========================================================================*/
/* LPUART1 (PB6/PB7): PC comm */
#define LPUART1_TX_GPIO_Port  GPIOB
#define LPUART1_TX_Pin        GPIO_PIN_6
#define LPUART1_RX_GPIO_Port  GPIOB
#define LPUART1_RX_Pin        GPIO_PIN_7
#define LPUART1_INSTANCE      LPUART1
#define LPUART1_DEFAULT_BAUD  19200U

/* UART4 (PC10/PC11): radio communication */
#define UART4_TX_GPIO_Port    GPIOC
#define UART4_TX_Pin          GPIO_PIN_10
#define UART4_RX_GPIO_Port    GPIOC
#define UART4_RX_Pin          GPIO_PIN_11
#define UART4_INSTANCE        UART4

/* USB OTG HS */
#define USB_DM_GPIO_Port       GPIOA
#define USB_DM_Pin             GPIO_PIN_11
#define USB_DP_GPIO_Port       GPIOA
#define USB_DP_Pin             GPIO_PIN_12
#define USB_VBUS_GPIO_Port     GPIOA
#define USB_VBUS_Pin           GPIO_PIN_9

/* ===========================================================================
 * 11. SD card / SPI / OCTOSPI / FDCAN pins (used by drivers)
 *
 *  The SDMMC2 data lines are NOT on PC8..PC12 - that was wrong here until
 *  2026-10 and happened to collide with FAN1_PWM (PC8) and UART4 TX/RX
 *  (PC10/PC11).  The .ioc puts them on the PB / PG bank instead; the values
 *  below are transcribed from it.  Note that CubeMX does not generate macros
 *  for the SDMMC2 signals, so unlike the GPIO pins above they cannot be
 *  aliased to main.h - re-check them against the ioc if the card moves.
 *
 *      ioc assignment:
 *          D0  = PB14      D1  = PB15      D2  = PB3   (not PC10)
 *          D3  = PG12      CK  = PD6       CMD = PD7   (not PC12 / PD2)
 *          CD  = PG15      (matches main.h's SDMMC2_CD_*)
 * ===========================================================================*/
#define SDIO_D0_GPIO_Port  GPIOB
#define SDIO_D0_Pin        GPIO_PIN_14
#define SDIO_D1_GPIO_Port  GPIOB
#define SDIO_D1_Pin        GPIO_PIN_15
#define SDIO_D2_GPIO_Port  GPIOB
#define SDIO_D2_Pin        GPIO_PIN_3
#define SDIO_D3_GPIO_Port  GPIOG
#define SDIO_D3_Pin        GPIO_PIN_12
#define SDIO_CK_GPIO_Port  GPIOD
#define SDIO_CK_Pin        GPIO_PIN_6
#define SDIO_CMD_GPIO_Port GPIOD
#define SDIO_CMD_Pin       GPIO_PIN_7
/* SD_CD is SDMMC2_CD in main.h; alias down to the short name. */
#define SD_CD_GPIO_Port    SDMMC2_CD_GPIO_Port
#define SD_CD_Pin          SDMMC2_CD_Pin

/* FDCAN1 (PD0/PD1) - matches the ioc */
#define FDCAN1_RX_GPIO_Port  GPIOD
#define FDCAN1_RX_Pin        GPIO_PIN_0
#define FDCAN1_TX_GPIO_Port  GPIOD
#define FDCAN1_TX_Pin        GPIO_PIN_1

/* ===========================================================================
 * 12. ADC channel rank (must match ioc Rank-N configuration)
 * ===========================================================================*/
/* ADC1: DMA circular, 9 ranks
 *
 * Directional-coupler numbering (fixed convention, same as OPA1000):
 *   coupler 1 = PA board -> LPF      (H4)
 *   coupler 2 = LPF      -> antenna  (H15)
 * The main GUI displays coupler 2, so every user-visible transmit power /
 * SWR figure and the software transmit limits come from coupler 2.
 */
#define ADC1_RANK_RF_IN      0U   /* INP4  (PC4)  - RF input power (D5/R40)      */
#define ADC1_RANK_IM         1U   /* INP5  (PB1)  - main current CC6920BSO-50A   */
#define ADC1_RANK_REV1       2U   /* INP6  (PF12) - coupler 1 reverse (H4-2)     */
#define ADC1_RANK_FWD1       3U   /* INP8  (PC5)  - coupler 1 forward (H4-4)     */
#define ADC1_RANK_REV2       4U   /* INP9  (PB0)  - coupler 2 reverse (H15-2)    */
#define ADC1_RANK_VBIAS      5U   /* INP14 (PA2)  - VBIAS_SENSE                 */
#define ADC1_RANK_FWD2       6U   /* INP15 (PA3)  - coupler 2 forward (H15-4)    */
#define ADC1_RANK_VM         7U   /* INP16 (PA0)  - main voltage                 */
#define ADC1_RANK_KEY_ADC    8U   /* INP17 (PA1)  - key resistor divider         */

/* ADC2: DMA circular, 2 ranks + 3 injected */
#define ADC2_RANK_IF_PA      0U   /* INP0  (PC2_C) - PA output 455kHz IF */
#define ADC2_RANK_IF_RADIO   1U   /* INP1  (PC3_C) - radio input 455kHz IF */
#define ADC2_INJ_NTC_CORE    0U   /* InjectedRank 1 = INP2 (PF13) - core NTC */
#define ADC2_INJ_NTC_AUX     1U   /* InjectedRank 2 = INP6 (PF14) - aux NTC  */
#define ADC2_INJ_TSENSE      2U   /* InjectedRank 3 = TEMPSENSOR           */

/* ===========================================================================
 * 13. ADC hardware watchdog channels
 * ===========================================================================*/
#define AWD1_CHANNEL         ADC_CHANNEL_4   /* RF input */
#define AWD2_CHANNEL         ADC_CHANNEL_5   /* main current */
#define AWD3_CHANNEL         ADC_CHANNEL_6   /* reflected power 1 */

/* ===========================================================================
 * 14. DAC outputs feeding COMP threshold inputs
 * ===========================================================================*/
/* COMP1 negative input = DAC1_OUT1 (RF input overdrive threshold) */
#define COMP1_INM_DAC_CHANNEL   DAC_CHANNEL_1
#define COMP1_INM_DAC_HANDLE     DAC1
/* COMP2 negative input = DAC1_OUT2 (main current threshold) */
#define COMP2_INM_DAC_CHANNEL   DAC_CHANNEL_2
#define COMP2_INM_DAC_HANDLE     DAC1

#ifdef __cplusplus
}
#endif

#endif /* HW_PINMAP_H */
