LuZening/OPA2000/Code_2/OPA2000_h7/User/Inc/key.h

/**
 * @file key.h
 * @brief Button Input Processing Header
 * @note 6 buttons: KEY1 on PC13 (PWR_WKUP4, keeps the wake-up path),
 *       KEY2..KEY6 on a resistor ladder read by ADC1_INP17 (PA1).
 */

#ifndef KEY_H
#define KEY_H

#ifdef __cplusplus
extern "C" {
#endif

#include "opa2000.h"
#include "hw_pinmap.h"

/*============================================================================
 * Button Definitions
 *============================================================================*/
#define KEY_POWER       0   /* PC13 KEY1_WKUP  - dedicated GPIO (wake-up)   */
#define KEY_MENU        1   /* ADC ladder     - menu                      */
#define KEY_BAND        2   /* ADC ladder     - band select               */
#define KEY_LEFT        3   /* ADC ladder     - left                      */
#define KEY_RIGHT       4   /* ADC ladder     - right                     */
#define KEY_ENTER       5   /* ADC ladder     - enter / confirm           */
#define KEY_COUNT       6

#define KEY_NONE        0xFFU   /*!< no ladder key recognised */
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
