LuZening/OPA2000/(commit log)

2026-10-13 Initial commit: OPA2000 H7 firmware codebase with shared public headers
    Clean baseline after git reset. 2039 files including:
    - STM32CubeMX-generated Core/ and Middlewares/ (Drivers, FreeRTOS, lvgl v7,
    FatFs, ST USB device library) — do not modify outside /* USER CODE BEGIN/END */
    - ioc configuration (OPA2000_h7.ioc) with H7B0ZBT6 (lceda U5), 9 ADC1 ranks,
    2+3 ADC2 channels, AWD1-3, COMP1/2, TIM2 OC+DMA (ALC), TIM1 ETR (freq),
    TIM15 (buzzer), TIM7 (FG polling), TIM3/TIM4 (fan/pump/backlight PWM),
    UART4 (radio), LPUART1+USB CDC, SDMMC2 (SD), I2C2 (touch), I2C3 (audio),
    LTDC 480x800, FDCAN1, OCTOSPI
    - User/Inc/ shared public headers (NEW this commit):
    hw_pinmap.h GPIO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
2026-10-13 refactor(opa2000): rewrite shared global types and utilities
    Replaces the old opa2000.h that mixed enum/struct definitions with
    ADC channel-index constants that didn't match the new ioc. The new
    header exposes:
    - ADC1_RANK_* / ADC2_RANK_* - rank-order constants matching the DMA
    buffer layout in user_adc.c (rf_in, im, rev1, fwd1, rev2, vbias,
    fwd2, vm, key_adc)
    - ADC1_RANK_COUNT = 9 (was ADC_CHANNEL_COUNT = 9 with different order)
    - Bond strings + frequency_to_band() ranges unchanged
    - Fan/protection default constants unchanged but typed as int16_t
    (was int/float mix)
    - AdcDataType now carries int32_t milli-unit values instead of float
    (the calibration functions in adc_calibration.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
2026-10-13 feat(power_control): rewrite RELAY/LPF/PSU/fan/pump with hw_pinmap.h
    Replaces the legacy power_control.c that had wrong pin assignments
    (PE2/PB11/PD14/PD15) inconsistent with the schematic. Now uses
    macros from User/Inc/hw_pinmap.h so any pin move is one-line.
    Highlights:
    - All outputs start LOW: PSU off, PWR_ON_SIG off, RF_BIAS off,
    RELAY1/2 off, RF_IN_PROTECT_CLEAR, all 6 LPFs LOW.
    - Default band = BAND_15M_10M on init / BAND_FAULT (per spec).
    - PTT EXTI5 ISR handles the full state machine without any
    FreeRTOS API call:
    IDLE -> TX_STARTING -> (15 ms TIM5) -> TX_RUNNING
    TX_RUNNING -> TX_STOPPING -> (15 ms TIM5) -> IDLE
    Re-pressing during TX_STOPPING cancels and re-closes R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
2026-10-13 feat(user_adc): rewrite ADC pipeline + IM zero-offset state machine
    - DMA buffer placed in DTCMRAM via .dma_buffer section for cache-coherent
    DMA (see STM32H7B0XX_FLASH.ld); 16-sample rolling average.
    - adc_process() runs the 9 ADC1 ranks through adc_calibration.h prototypes
    and stores int32_t milli-unit values into g_adc_data, then computes
    swr_x100 via the integer Newton sqrt in opa2000.c.
    - adc_im_zero_offset_tick() implements the CC6920BSO-50A calibration
    state machine:
    phase 1 (sampling): 50 samples ~ 500 ms at 10 ms tick
    phase 2 (validate): |avg - 43254| <= 1048 LSB => success
    retry up to 3 times then g_alert_active = ALERT_HARDWARE_FAULT.
    On success: g_config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
2026-10-13 feat(protection): rewrite atomic shutdown for hardware + software triggers
    Single path protection_trigger_locked(cause) used by every trigger
    (AWD1/2/3, COMP1/2, EXTI12, task-side protection_check):
    1. drop both RELAYs
    2. drop PWR_ON_SIG (PG7)
    3. drop RF_BIAS_ON (PG2)
    4. raise RF_IN_PROTECT_CPU_SIG (PB13) -> hardware latch via D7
    5. publish volatile state (g_alert_active, g_alert_flag, g_allow_rf=0)
    6. clear g_ptt_active, g_power_state = POWER_STATE_OFF
    ISR handlers: protection_hardpwr_err_isr (PB12 rising),
    protection_comp1_isr (RF input overdrive), protection_comp2_isr
    (main current overcurrent), protection_awd{1,2,3}_cb for ADC1 watchdogs.
    Task side protection_check() runs o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
2026-10-13 feat(freq_detect): rewrite TIM1 ETR + TIM7 100us with hw_pinmap guards
    Replaces the legacy code that referenced TIM4 (wrong timer; TIM4 is
    used for PUMP_PWM/BL_PWM/RELAY-delay fan PWM) and TIM7 for the
    100us tick. Correct mapping per hw_pinmap.h:
    TIM1 (Channel ETR Mode 2) <- ETR_FREQDET (PE7)
    TIM7 update every 100 us <- sample counter
    Sequence in ISR (no FreeRTOS API):
    1. read TIM1->CNT
    2. subtract previous (with 16-bit wrap handling)
    3. freq_hz = delta * 10000
    4. publish g_radio_freq_hz (volatile)
    5. if freq > 1 MHz and g_power_state == TX and measured band !=
    g_current_band and not already latched -> call
    protection_trigger_locked(ALERT_FREQ_MISMATCH).
    Task-si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
2026-10-13 feat(control): add buzzer state machine + ALC dual-DMA PWM + fan TACH
    buzzer.c (no DMA, integer-only state machine driven by TIM7 tick):
    - 4 states: high 300 ms, mid 300 ms, low 300 ms, silence 3 s
    - TIM15 CH2 PWM output (prescaler /16, ARR computed from freq)
    - All access from TIM7 update ISR, no FPU
    alc_pwm.c (TIM2 OC + dual DMA -> GPIOG BSRR):
    - TIM2 ARR=999 -> 200 kHz PWM at default 50% duty
    - CH1 match (CCR1) -> DMA writes (1<<0) to GPIOG BSRR (PG0 high)
    - CH2 match (CCR2) -> DMA writes (1<<16) to GPIOG BSRR (PG0 low)
    - GPIOG->BSRR absolute = 0x58021818 (GPIOA base 0x58020000 + 6*0x400 + 0x18)
    - alc_pwm_set_period / set_pulse runtime-updateable
    - alc_bsrr_set / alc_b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
2026-10-13 chore: remove unused PCA9539 + EEPROM files (I2C expand key option dropped)
    PCA9539 I/O expander was the legacy external-key option dropped per
    firmware spec section [3. external keypad]. All keypad logic now
    flows through ADC1_INP17 (PA1) resistor-divider key decoder.
    EEPROM driver (legacy F-RAM/AT24C-style I2C backup) is unused because
    configuration now lives on the SD card (/fs/config.bin via Networking
    agent's sdconfig.cpp).
2026-10-14 chore(cubemx): regenerate from the current .ioc
    Full regeneration with one file per peripheral (Core/Src/adc.c, tim.c,
    usart.c, ...), which replaces the monolithic stm32h7xx_hal_msp.c.
    Notable configuration changes carried in here:
    - UART4 RX/TX DMA switched to DMA_NORMAL (radio_uart.c ping-pong buffers
    assume Normal, not Circular)
    - IRQ handlers now declared/generated: UART4, LTDC, LTDC_ER, BDMA2 CH0/1,
    LPUART1, ADC, EXTI2, EXTI9_5, DMA1_Stream4/5, DMA2_Stream1/6/7
    - HAL / CMSIS / FreeRTOS package refreshed
2026-10-14 feat(control): radio CAT over UART4, plus build fixes for the new CubeMX layout
    Radio link: ICOM CIV / Kenwood / Yaesu frequency readback on UART4, framed
    by DMA + IDLE line with ping-pong buffers (DMA_NORMAL). Receiver type is
    detected from the wire signature, a frame takes effect immediately, and a
    malformed frame is dropped rather than allowed to move the band. A poll
    frame goes out every 100 ms, and the accumulator is reset by any byte sent
    or received.
    Build fixes needed by the per-peripheral CubeMX layout:
    - config.h declared a config_t blob and a config_load/config_init_default
    API that config.c never implemented, while every caller used
    config_init/config_save/config_res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
2026-10-14 wip(gui): restore GUI work lost during the wt-control merge
    The GUI agent's uncommitted gui.c was overwritten when User/ was checked out
    from wt-control. Recovered from the Trae local-history timeline
    (History/c79335, last snapshot 2026-10-14 18:19:54).
    Restores 424 lines that had no counterpart in the merged file, including
    gui_update_protocol_label(), si_build_table(), cc_refresh_ui(),
    prot_from_config() / prot_to_config() and make_centered_label().
    Does NOT compile yet - it references interfaces the GUI agent expects but
    that opa2000.h never declared:
    g_power_state / POWER_STATE_{OFF,STANDBY,TX}
    g_config.touch.* (x_a_q10 / x_b_q10 / y_a_q10 / y_b_q10)
    g_config.temp_fah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
2026-10-14 feat(config): add the interfaces gui.c expects, and wire them up
    gui.c (recovered from the local-history timeline) referenced a set of
    symbols that opa2000.h never declared, so it could not compile. Add them
    with the semantics the GUI agent documented:
    touch_cal_t x_gain / x_offset / y_gain / y_offset / calibrated
    Renamed from the previous touch_cal.{x_slope,...,valid}. touch.c is
    updated to match.
    coupler_t gain_uW_per_code / offset_mW
    Per-coupler trim: power_mW = raw * gain_uW_per_code / 1000 + offset_mW.
    Slope in micro-Watt per code keeps it an exact integer without
    fixed-point. Zero gain means "uncalibrated" - adc_calibration.c
    keeps using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
2026-10-14 feat(config): store the config in internal flash instead of FatFs
    Replaces the SD-card backend with an EEPROM ring on the H7B0's own flash,
    and defers every write to a low-priority task.
    Why internal flash rather than a card: FatFs needs ffconf.h plus a mountable
    drive, and neither existed. The config blob is 124 bytes, so 32 KB of flash
    is a comfortable fit and removes a whole subsystem from the boot path.
    Geometry that shapes the design (from stm32h7b0xx.h):
    - 8 KB sectors, 128 KB total - NOT the 128 KB sectors of the larger H7
    - the array is 137-bit words (128 data + 9 ECC), so the programmable
    granularity is 16 bytes and the ECC cannot be disabled. A word can be
    written o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
2026-10-14 fix(flash): use the HAL on H7B0, and cut the load path's RAM to a minimum
    HAL instead of raw registers
    The HAL was unusable because stm32h7xx_hal_def.h includes the legacy header
    unconditionally, and that header references FLASH_VOLTAGE_RANGE_3 at line 485
    with no guard - while stm32h7xx_hal_flash_ex.h defines that macro family inside
    #if defined (FLASH_CR_PSIZE), and stm32h7b0xx.h never defines FLASH_CR_PSIZE.
    So any file pulling in the flash HAL failed to compile.
    Rather than patch the driver tree, User/Inc/h7b0_flash_compat.h defines the
    missing FLASH_CR_PSIZE field and the four RANGE macros before the HAL is
    included, with values from RM0490 (PSIZE = bits [9:8]). Nothing under
    Drivers/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
2026-10-15 feat(control): 电源轨解耦、COMP 阈值可调、CAT 协议解析移出中断
    电源部分（改动最大）：
    - 把「主电源 / 高压轨 / 射频通路」三条轨彻底解耦，函数名按轨区分，
    删掉语义误导的 power_on/power_off
    - PG5 改为外部 PSU 语义（高=开、低=关，板上经 Q9 反相）；power_init()
    不再擅自开机 PSU，唯一主动关机点是 power_soft_off()
    - 高压轨两拍非阻塞时序：PWR_ON -> 10ms -> RF_BIAS，monitor task tick
    由 100ms 改为 10ms 驱动（其余工作用 slow_div 分频回 100ms）
    - 发射联锁不再检查 g_psu_on / g_hv_on，只保留 power_rail_busy()
    与 allow_RF / alert_flag
    保护部分：
    - 保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
2026-10-15 fix(build): 修复 ARM 与 host 两侧的编译错误并补上高压轨时序 bug
    上一轮改动只做了静态推理，这次真正把两套构建都跑通，暴露出 6 个
    此前没被发现的错误，其中两个是会影响硬件行为的功能缺陷。
    功能缺陷：
    - power_hv_off() 只清了 s_hv_stage 和 g_hv_on，忘了真正拉低 RF_BIAS。
    结果下高压时偏置根本没断，10 ms 间隔也就无从谈起。
    - power_init_outputs() 没有清 g_hv_on。引脚已经全部归位到 inactive，
    标志却还留着 true，之后 power_hv_on() 会误判为已稳定上电而直接
    返回，整条上电时序被跳过。
    编译修复：
    - gui.c: gui_process_poweroff() / pow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
2026-10-15 fix(gui): 修复模拟器崩溃与状态行截断
    上一轮加 #ifndef LVGL_SIM 时误伤了 gui_init()，模拟器一启动就以
    0xC0000005 退出；顺带把状态行和两处 sim 侧的悬空引用修掉。
    - gui_init(): gui_mutex_init() 重新改为无条件调用。模拟器下 gui_lock()
    走 Windows CRITICAL_SECTION，对未初始化的 CS 调 EnterCriticalSection
    直接访问违例。之前那个 guard 不是无害跳过，是必崩。
    - gui_update_debug_overlay(): 顶部状态行在模拟器下不再引用
    g_touch_type。touch.c 依赖 STM32 HAL，本就不参与 sim 构建，那个符号
    在 sim 下没有定义。sim 无 I2C，用编译期常量上报 none 即可。
    - gu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
2026-10-15 chore: 忽略图片产物与 host 测试构建目录
    gui_shots/ 下 16 张模拟器截图已从索引移除（磁盘文件保留），并加上
    图片类型的 ignore 规则，避免每次重跑 sweep 都产生一批无意义的 diff。
    同时忽略 User/Tests/build*/：host 单元测试的构建树，原先的
    build/ 规则只覆盖了 ARM preset 那一个目录。
    Middlewares/Third_Party/lvgl/tests/ 下的 3 张图是 LVGL 上游自带的测试
    夹具，不是截图产物，保持跟踪 —— .gitignore 不追溯已跟踪文件，所以它们
    本来也不受影响，这里只是把边界写清楚。
2026-10-15 refactor(hw_pinmap): 引脚号真相源归一到 CubeMX，并修正 SDMMC2 引脚
    hw_pinmap.h 之前把 CubeMX 已经生成的引脚又硬编码了一遍，两套宏名字还
    不同（PWR_ON_Pin vs PWR_ON_SIG_Pin）。#ifndef 保护对不同名的宏无效，
    所以编译不报错、ioc 改了引脚也没人提醒 —— 这是静默失配，不是编译错误。
    改法：hw_pinmap.h 保留短名，但值改成指向 main.h 的别名。调用点一行不动，
    而 ioc 重新生成后固件自动跟随；名字对不上时编译器会直接报错。
    分工现在写进文件头：
    - ioc 生成的（GPIO） → 真相源 main.h，本文件只做别名
    - ioc 不产生的（定时器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
2026-10-15 fix(touch): GT911 与 NS2009 同在 I2C2，按 7 位地址区分
    两颗触摸控制器都挂在 I2C2（PF0/SDA、PF1/SCL）上，靠地址区分：
    NS2009 RTOUCH 电阻 7 位 0b1001000 = 0x48
    GT911 CTOUCH 电容 7 位 0b0010100 = 0x14
    之前 GT911 走的是 hi2c3（PA8/PC9），那条总线上什么都没接，电容触摸
    永远探测不到；地址也写成 0xBA（0x5D<<1），与本板实际不符。
    - GT911 全部 I2C 访问改到 hi2c2，地址改为 (0x14 << 1) = 0x28
    （HAL 要 8 位地址，R/W 落在 bit0）
    - 文件头与 touch_detect_type() 的注释同步：两条总线改为一条，
    并去掉早已删除的 XPT2046/SPI1 探测顺序说明
    - ns2009.h 里「I2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
2026-10-15 feat(touch): 触摸驱动改为 I2C2 + DMA 非阻塞状态机
    原来 touch_process() 每 10 ms 同步读一次总线，而 HAL 的等待循环是纯自旋
    （stm32h7xx_hal_i2c.c 的 I2C_WaitOnFlagUntilTimeout 里 while 轮询，没有
    osDelay/taskYIELD，不让出 CPU）。芯片不应答时每次最多自旋 100 ms，GUI
    任务这一圈就废掉，屏幕刷新率掉到几 Hz。
    架构：
    - touch.c 里一个 DMA 状态机负责两个控制器的读序列。必须集中在一个文件：
    HAL_I2C_MemRxCpltCallback() 只认句柄不认从机，NS2009 与 GT911 共用同
    一个回调，分散写无法区分是谁的回调。
    - 传输完成中断里解码并写 volatile 快照，不碰 LVGL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
2026-10-15 feat(touch): 总线恢复重挂 + I2C 错误诊断
    上一次提交只做到了"中止在途事务"，救不回被从机拉死的总线：从机可能正好停在
    发了一半的字节上，还在等第 N 个时钟沿，而主机已经放手了。这时唯一有效的办法
    是主机继续把时钟打完。
    新增 touch_bus_recover()，步骤与顺序都照 ST 的推荐做法：
    1. HAL_I2C_DeInit() 摘掉外设，释放引脚与 DMA/中断绑定；
    2. SCL/SDA 临时配成开漏 GPIO，SDA 释放为高，SCL 由我们驱动；
    3. SCL 打 9 个完整时钟（8 数据 + 1 应答），让从机把剩余的位发完；
    4. 补一个 STOP 时序：SDA 低 → SCL 高 → SDA 高；
    5. M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
2026-10-16 feat: 多轮 P0/P1 保护 + Sensors ADC2 + Band Comm 双 Baud + CMakePresets
    本轮 commit 覆盖三个分支:
    1. 保护机制重做
    - 引入 P0 (紧急) / P1 (温和) 两级 severity
    - P0 路径: 关 bias / 切保护信号 / 关 HV / 锁存保护 (hard shutdown)
    - P1 路径: 仅拒绝 PTT, 不断电 (例如过热/风扇异常)
    - 三段式 buzzer 报警 + 10s 强制超时
    - dismiss 分级: P0 需 operator 显式恢复, P1 直接 ack
    - 保护触发改为 AWD/DMA 完成中断路径 (而非 task 轮询)
    - band-mismatch 失配保护带 ±500 kHz 误差带 (LVGL roller 可调)
    2. Sensors 与 Band Comm 弹窗改造
    - Sensors 屏加 ADC2 子表 (PA IF / Radio IF / Core NTC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
2026-10-17 chore: 建立 OPA2000 硬件父仓库，纳入原理图/PCB/BOM 设计源文件
    跟踪 LCEDA / MCU_2 / Power_2 / RF_2 / LPF_2 / Interface_2 六个硬件设计目录。
    Code_2/ 下的固件工程以 submodule 形式接入，暂不提交其内容。
    reference/ 与仿真导出（.fft/.raw）排除：前者是厂商第三方资料，后者体积大且可重新导出。
2026-10-17 feat(sdcard): 接入 CubeMX FatFs 与 SD 卡存储层
    CubeMX 重新生成工程后补齐 FatFs 集成：
    - 纳入 FATFS/ 生成的胶水层（fatfs / bsp_driver_sd / sd_diskio / fatfs_platform）
    - FatFs R0.12c 引擎同步到 CubeMX 版本，启用 ffconf.h 的 FreeRTOS 堆配置
    - CMake 新增 FatFs OBJECT 库，解除 sdcard_storage.c 的构建阻塞
    - 移除未被使用的 USB MSC 类（设备暂不通过 USB 导出 SD 卡）
    - 移除 CubeMX 一并删掉的 CMSIS DSP/NN 源码（本工程未引用）
2026-10-17 Merge OPA2000_h7 firmware history into Code_2/OPA2000_h7
    将原独立固件仓库以 subtree 方式并入本仓库，历史完整保留：
    git log -- Code_2/OPA2000_h7
    原仓库 .git 已备份至仓库根的 .git_backup_opa2000_h7/（未跟踪），
    确认无误后可删除。
2026-10-17 chore: 纳入其余 Code_2 子工程，改为单一顶层仓库
    把 OPA2000_h7_Bootloader / OPA2000_h7_MSC_TEMPLATE /
    H7B0ZB_W25Q128_HSI_ExternalLoader / OPA2000_MCU_simple_test 一并纳入版本控制，
    配合已 subtree 并入的 OPA2000_h7，本仓库现为 OPA2000 的唯一来源。
    同时排除本地的原固件仓库备份目录 .git_backup_opa2000_h7/。
2026-10-17 fix(build): 启动文件路径跟随 CubeMX 1.21 迁移到 Core/Startup
    CubeMX 1.21 把 startup_stm32h7b0xx.s 移到 Core/Startup/ 并按实际料号
    重命名为 startup_stm32h7b0zbtx.s，CMake 源列表同步更新。
2026-10-17 fix(bootloader): ExternalLoader 恢复 OCTOSPI 初始化，Bootloader .ioc 重命名
    - Loader_Src.c 的 Write/SectorErase/EraseBlock 重新启用
    W25Q128_OCTO_SPI_Init 失败检查，OSPI 未初始化时直接返回 LOADER_FAIL
    而不是继续写入导致静默数据损坏
    - OPA2000_h7.ioc 更名为 OPA2000_h7_Bootloader.ioc，与工程名对齐
2026-10-17 chore: 移除已失效的固件仓库备份忽略规则
    .git_backup_opa2000_h7/ 已在 GitHub 推送验证后删除。
2026-10-18 feat(protection): 上电稳定等待期，消除上电瞬间的误报警
    上电时模拟前端尚未稳定 —— 电源轨还在爬升、D5/R40 峰值检波器刚脱离
    复位电平、CC6920 输出停在偏置网络的不确定点上。此时就把操作员设定的
    真实门槛下发下去，开机瞬间必然锁存一个保护报警。
    新的上电时序：
    1. main() 在外设初始化完成后立刻调 boot_hold_thresholds_open()：
    AWD1/2/3 高通阈值推到 16 位满量程，COMP1/COMP2 的 DAC1_CH1/CH2
    参考推到 VDDA 轨（12 位满码 4095），同时把 CLEAR_FAULTX_OC 拉低。
    任何转换结果都越不过满量程，参考在轨上的比较器也翻不转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
2026-10-18 feat(fan): 风扇/水泵转速实测上报，修复手动档位被温控覆盖
    转速统计（fan_tach.c 重写）
    - RPM 换算改用 HAL_GetTick() 实测窗口，不再依赖硬编码的 100 ms。
    monitor 任务实际周期是 1000 ms（vTaskDelayUntil 100 ms + slow_div
    分频 10），原实现会把读数放大 10 倍。
    - 删除 fan_tach_start()/stop()：从未被调用，且会按 500 us 重写
    htim7 的 PSC/ARR，覆盖 freq_detect.c 的 100 us 周期。fan_tach
    现在只挂在 TIM7_IRQHandler 里数边沿，不碰定时器寄存器。
    - fan_tach_init() 补上调用点（app_monitor_task）。
    - PPR 拆成 FAN_POLES / PUMP_POLES 两个独立常量并移入头文件。
    水泵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
2026-10-26 feat(protection): HV 涌流期间屏蔽 Im 过流保护，新增定时清除故障锁存接口
    高压上电瞬间的充电涌流会被 AWD2/COMP2 判为过流，此时功放尚未按键，
    属于误报。新增一个标志位级的屏蔽窗口：power_hv_on() 在 PWR_ON 拉高
    之前置位，AWD2/COMP2 两条中断路径在 note_source 之前门控，monitor
    任务到期清除并把 CLEAR_FAULTX_OC 重新拉高。
    CLEAR_FAULTX_OC 改为单一所有者（位掩码），涌流屏蔽、定时清除服务、
    弹窗解除脉冲三条路径共享，一个脉冲结束不会把另一个截短。
    新增 protection_clear_fault_safe(ms)：调用方（中断或任务）只置标志，
    由 monitor 任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
2026-10-26 chore(structures): 纳入面板边框与支架等机械结构件
    三个 SolidWorks 零件（屏幕边框 480x272、43 寸版本、面板固定螺丝）
    及屏幕边框的 STL 导出，与 Interface_2/、LPF_2/ 等目录中已跟踪的
    机械 CAD 文件保持一致。STL 供 3D 打印或结构预览使用。
