LuZening/OPA2000/(notices)

Notices in the files:
Code_2/OPA2000_h7/Core/Src/adc.c:
Copyright (c) 2026 STMicroelectronics.
All rights reserved.
This software is licensed under terms that can be found in the LICENSE file
